marcos-paltatech/sonar-invidentes/hardware/img/srf02.png

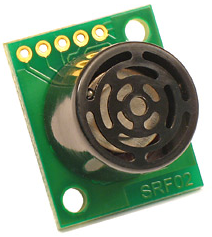
hardware/img/srf02.png
