marcos-paltatech/sonar-invidentes/readme.txt

audio/
    Tracks de audio, instrucciones para grabar tracks, etc.
    Utilizamos Audacity para manipular audio.

datasheets/
    Datasheets de componentes, application notes, etc.

doc/
    Archivos de documentacion varios.

flashmem/
    Programa para flashear la memoria flash del sistema.
    Esta implementado en C++ con Qt y funciona en Linux.

hardware/
    Esquematicos y archivos relacionados a la implementacion del proyecto en una placa.
    El proyecto esta hecho con KiCAD.

hardware_proto/
    Esquematicos y archivos relacionados a la implementacion de prueba del proyecto,
    utilizando una placa STM32-Discovery.
    El proyecto esta hecho con KiCAD.

STMProject/
    Proyecto para el prototipo usando la placa STM32-Discovery.
    El proyecto es para el IDE "Atollic TrueSTUDIO for STMicroelectronics STM32".
	
SonarBoardProject/
	Proyecto para la placa SonarBoard.
	El proyecto es para el IDE "CooCox".
