marcos-paltatech/sonar-invidentes/hardware/doc/sonarboard_1.png

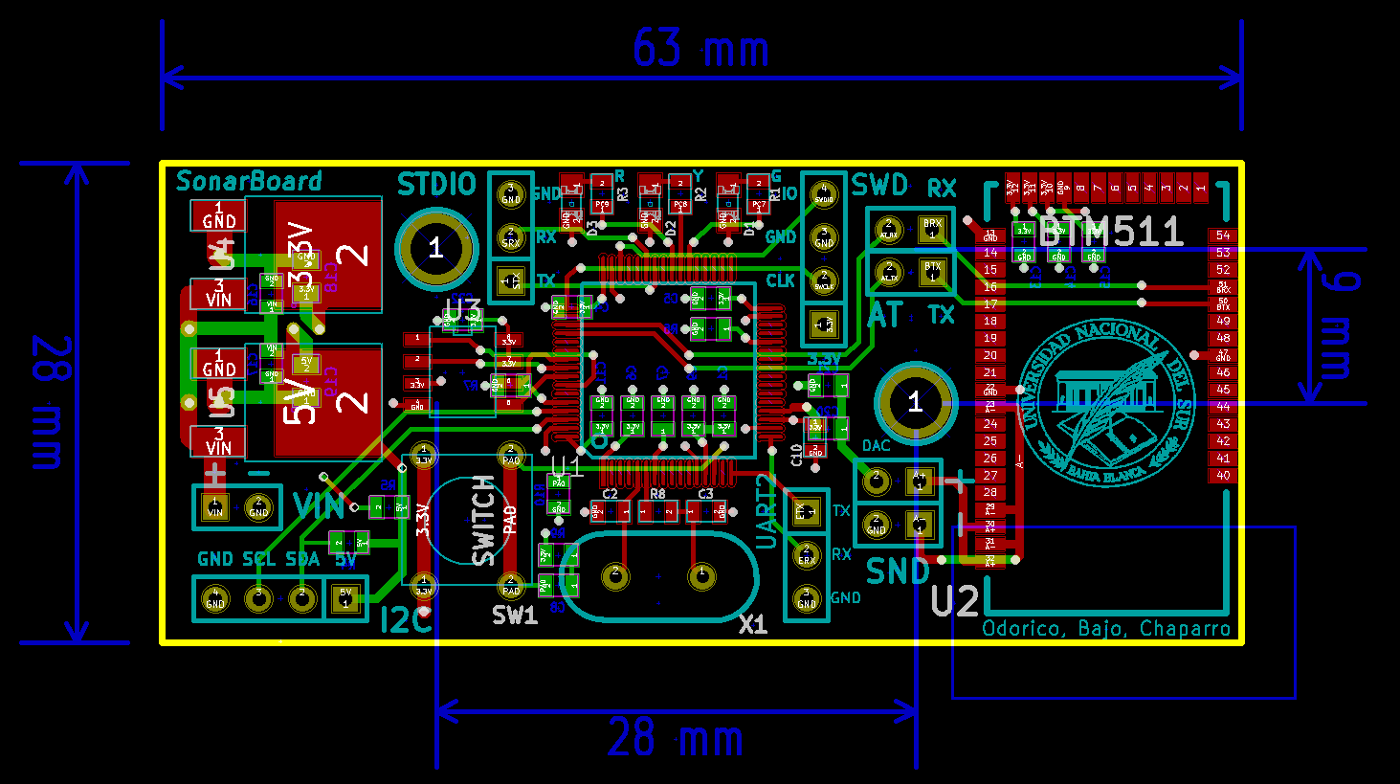
hardware/doc/sonarboard_1.png
