marcos-paltatech/sonar-invidentes/hardware/doc/sonarboard_1_3d.png

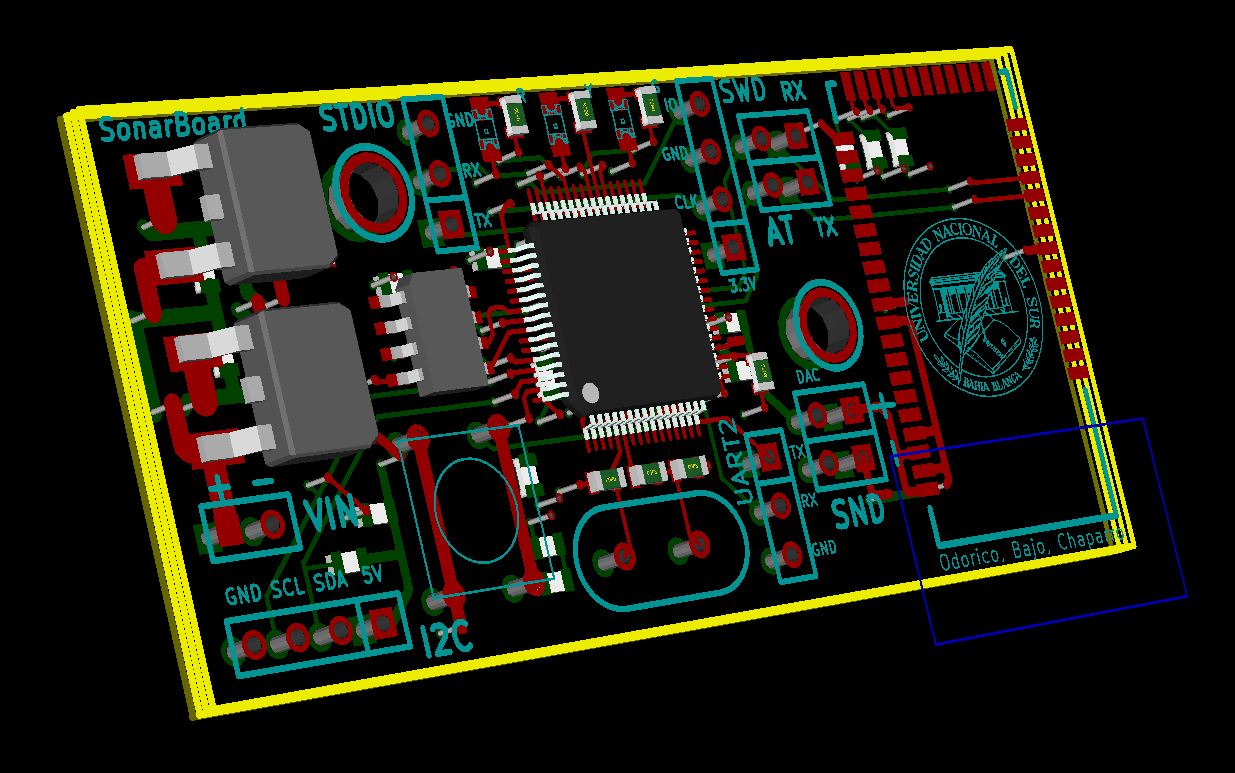
hardware/doc/sonarboard_1_3d.png
