marcos-paltatech/sonar-invidentes/hardware/doc/sonarboard_2.png

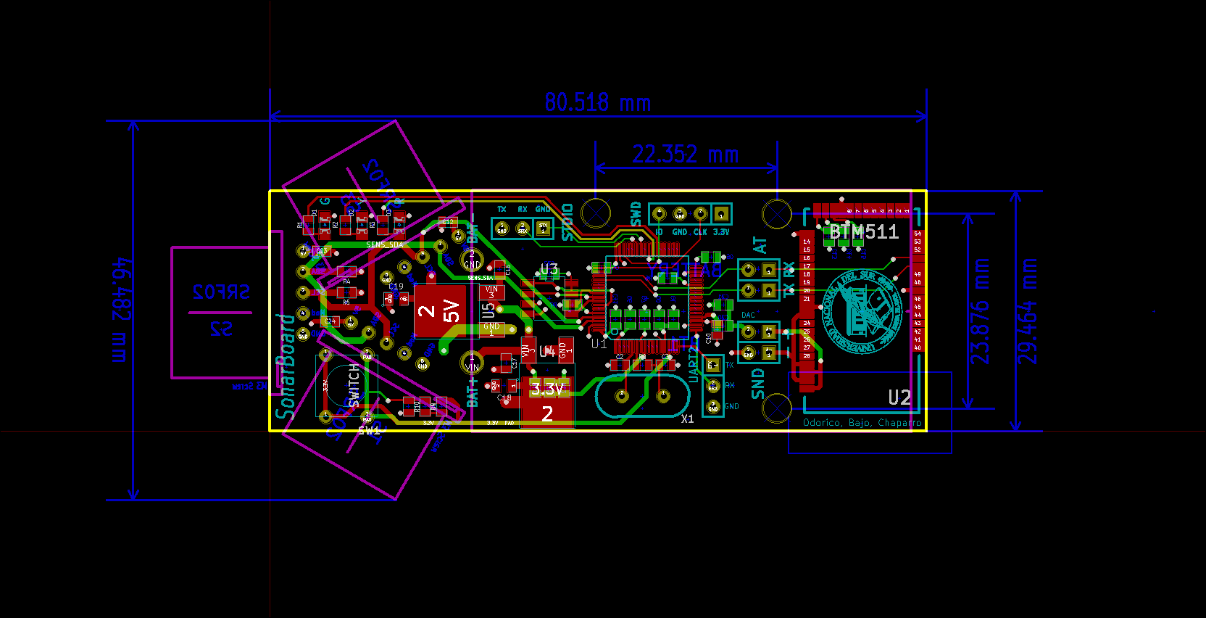
hardware/doc/sonarboard_2.png
