marcos-paltatech/sonar-invidentes/hardware/img/bluetooth.png

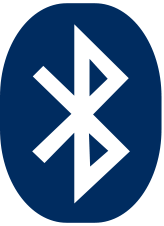
hardware/img/bluetooth.png
