marcos-paltatech/sonar-invidentes/hardware/img/ld1117.png

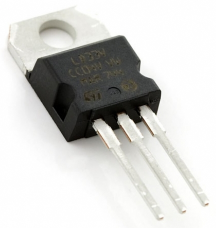
hardware/img/ld1117.png
