marcos-paltatech/sonar-invidentes/hardware/img/stm32.png

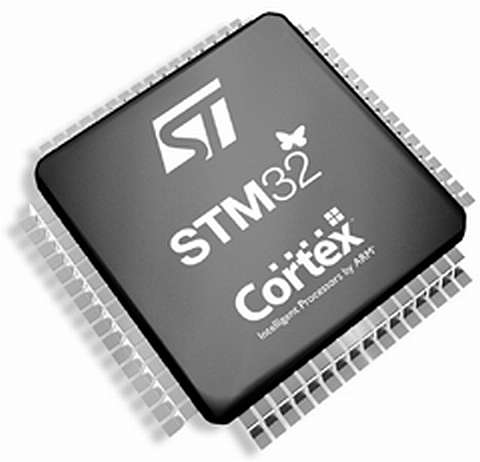
hardware/img/stm32.png
