marcos-paltatech/sonar-invidentes/hardware/img/uns.png

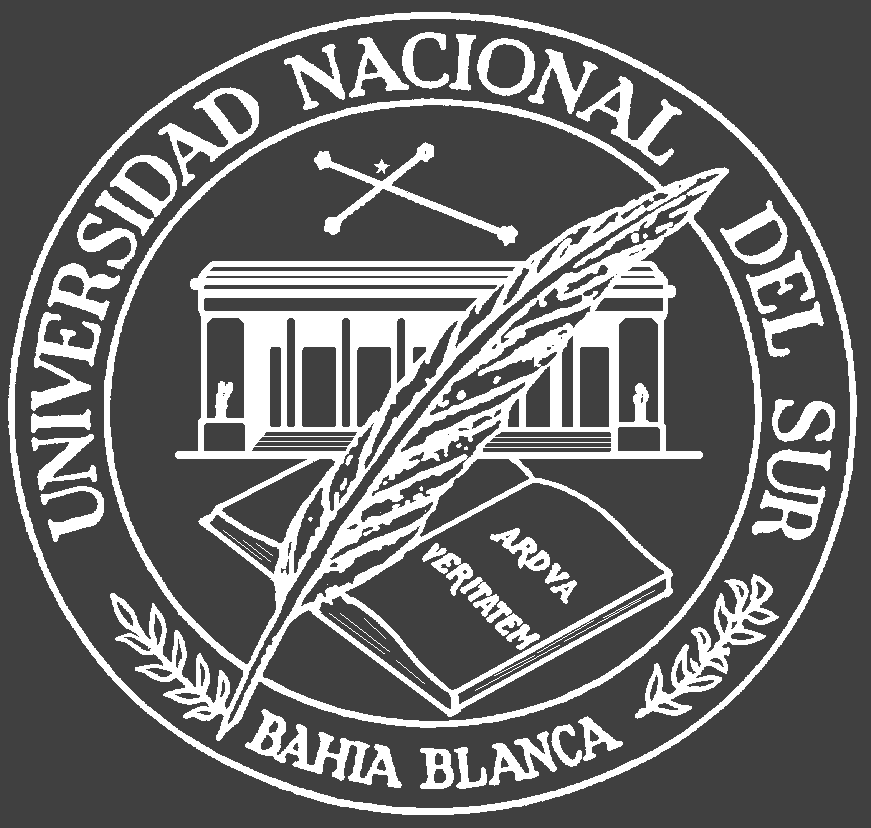
hardware/img/uns.png
