marcos-paltatech/sonar-invidentes/hardware_proto/sonar.pdf

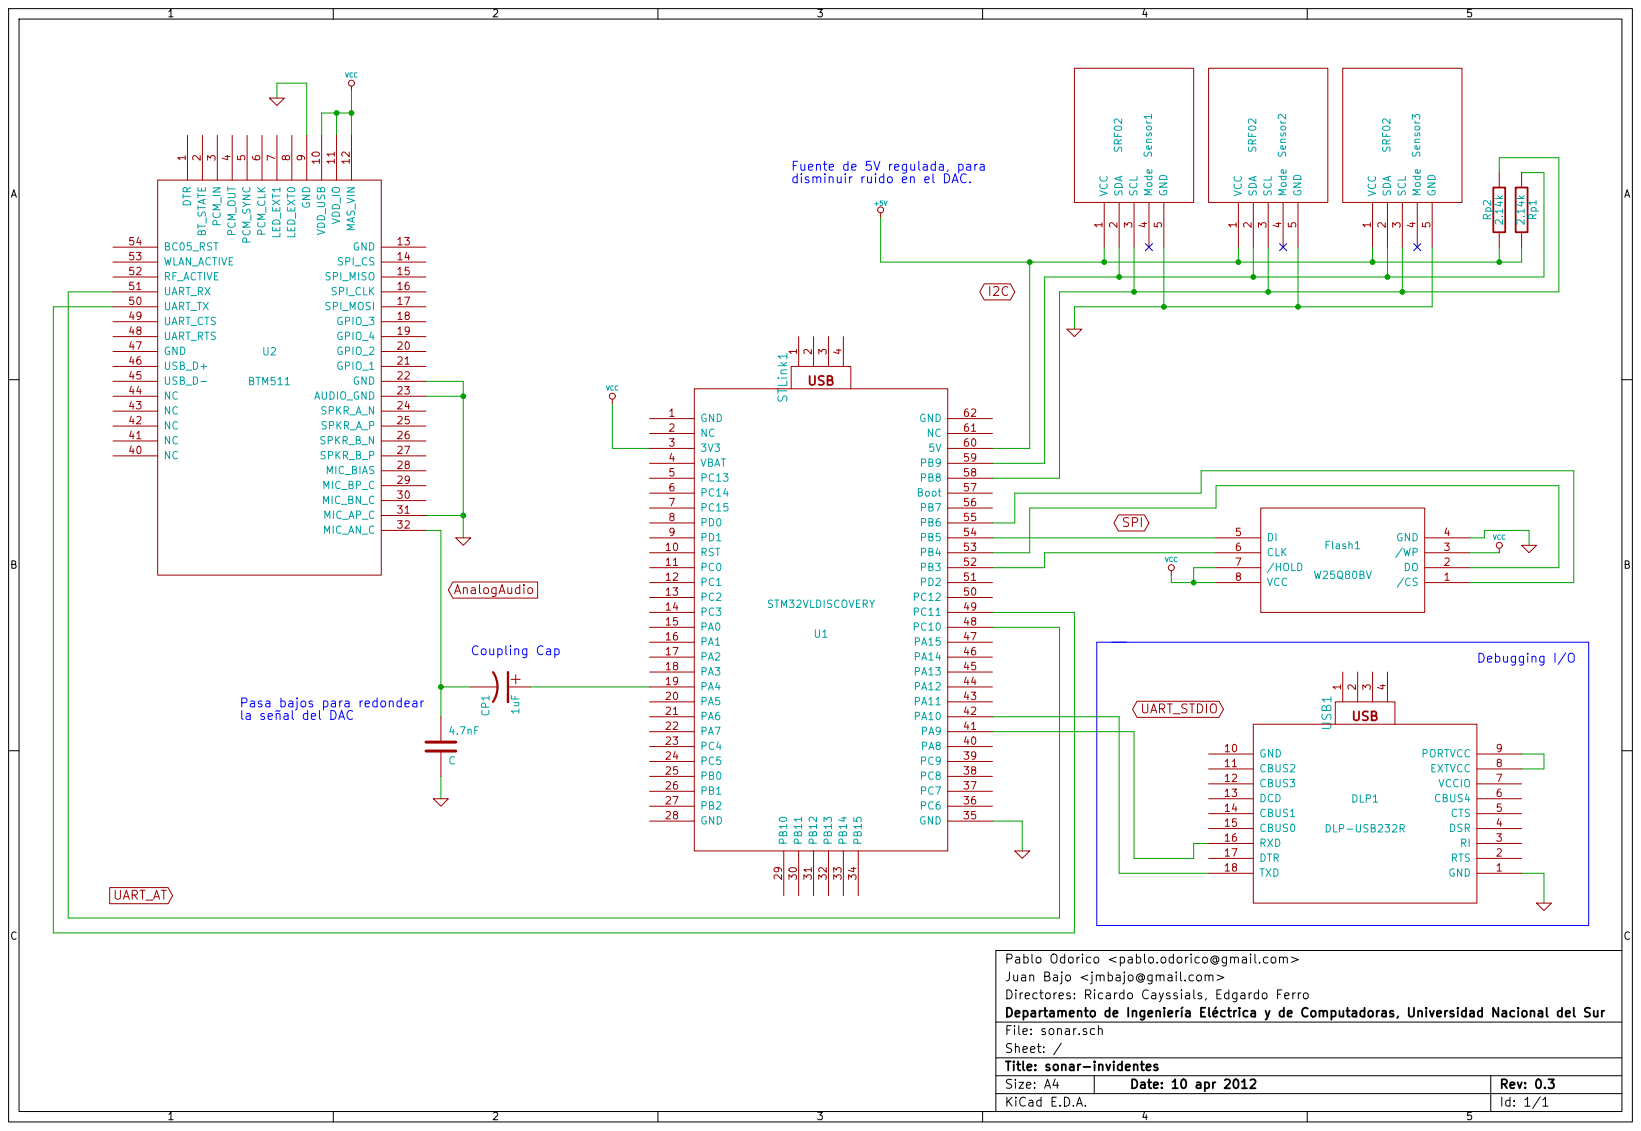
[picture p9: page 1]
