marcos-paltatech/sonar-invidentes/hardware/doc/sonar_board_v04.pdf

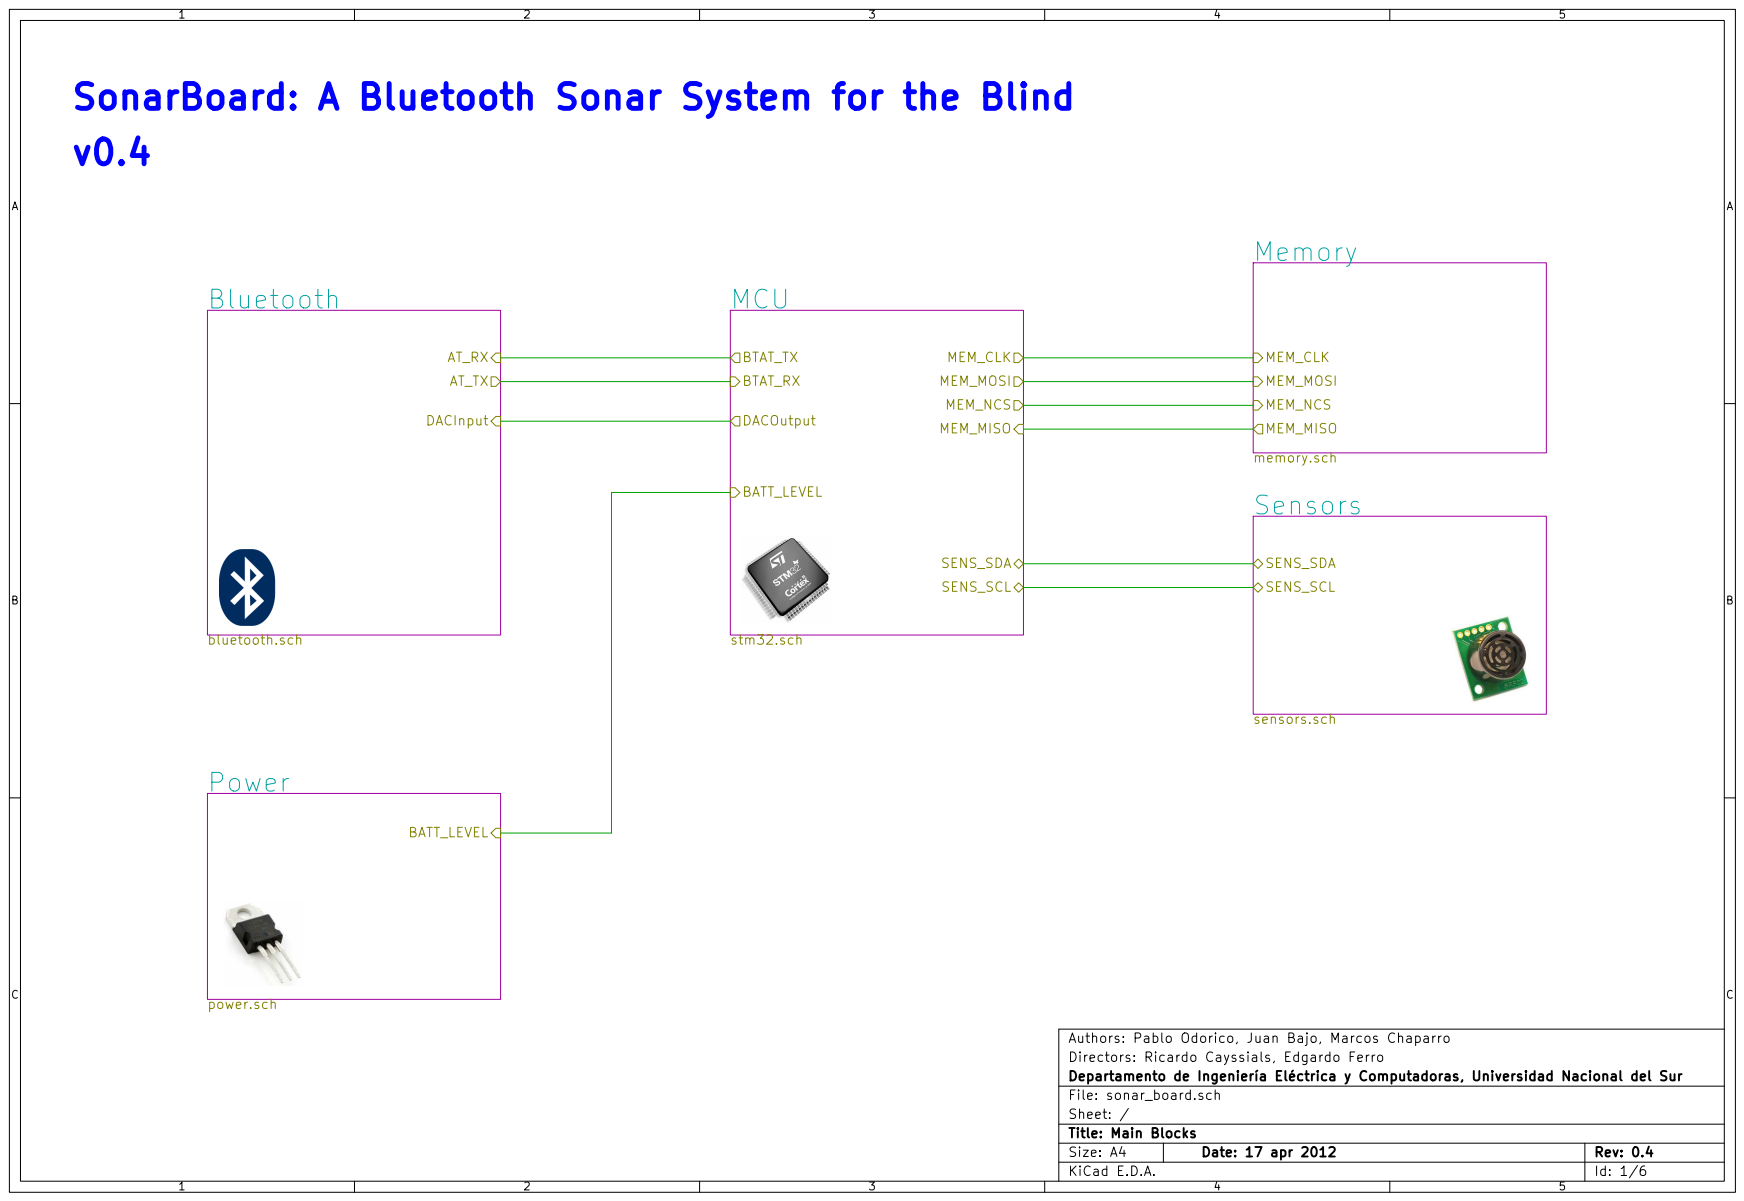
[picture p10: page 1]

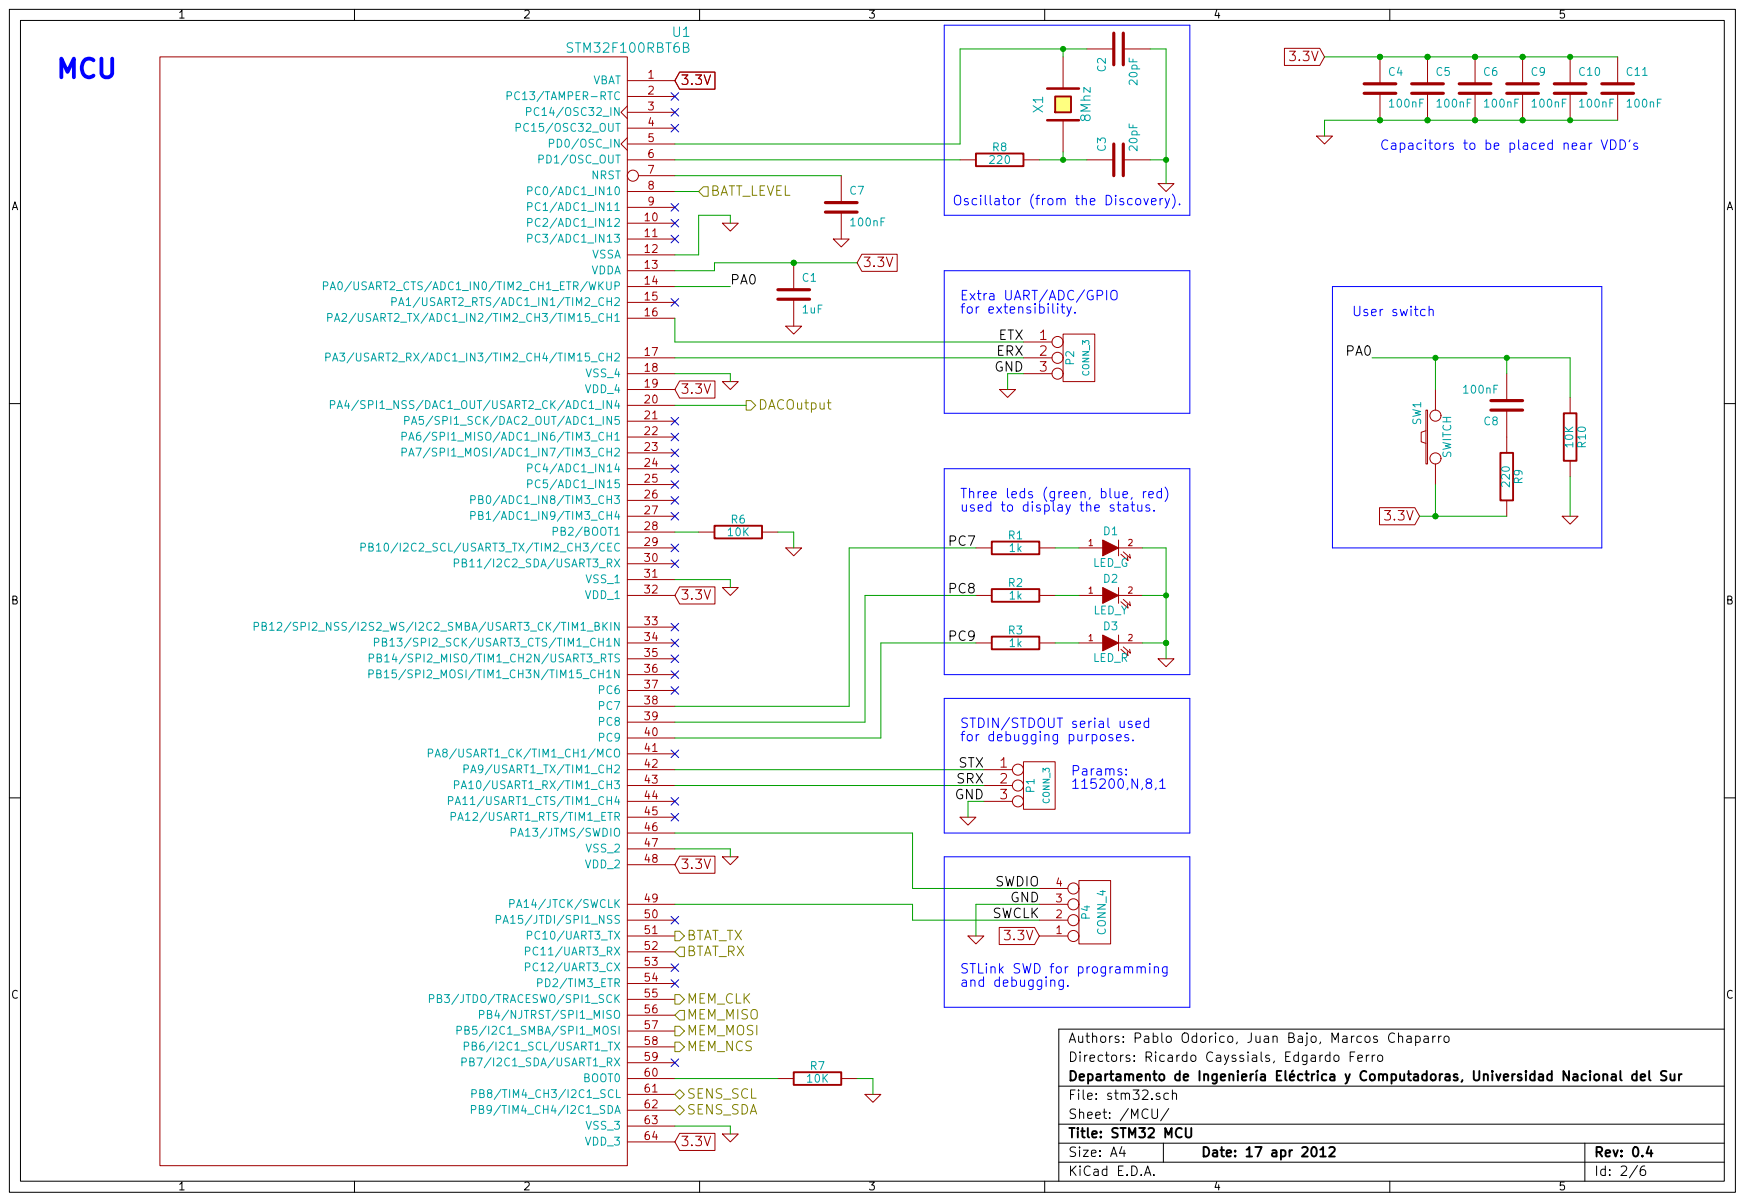
[picture p11: page 2]

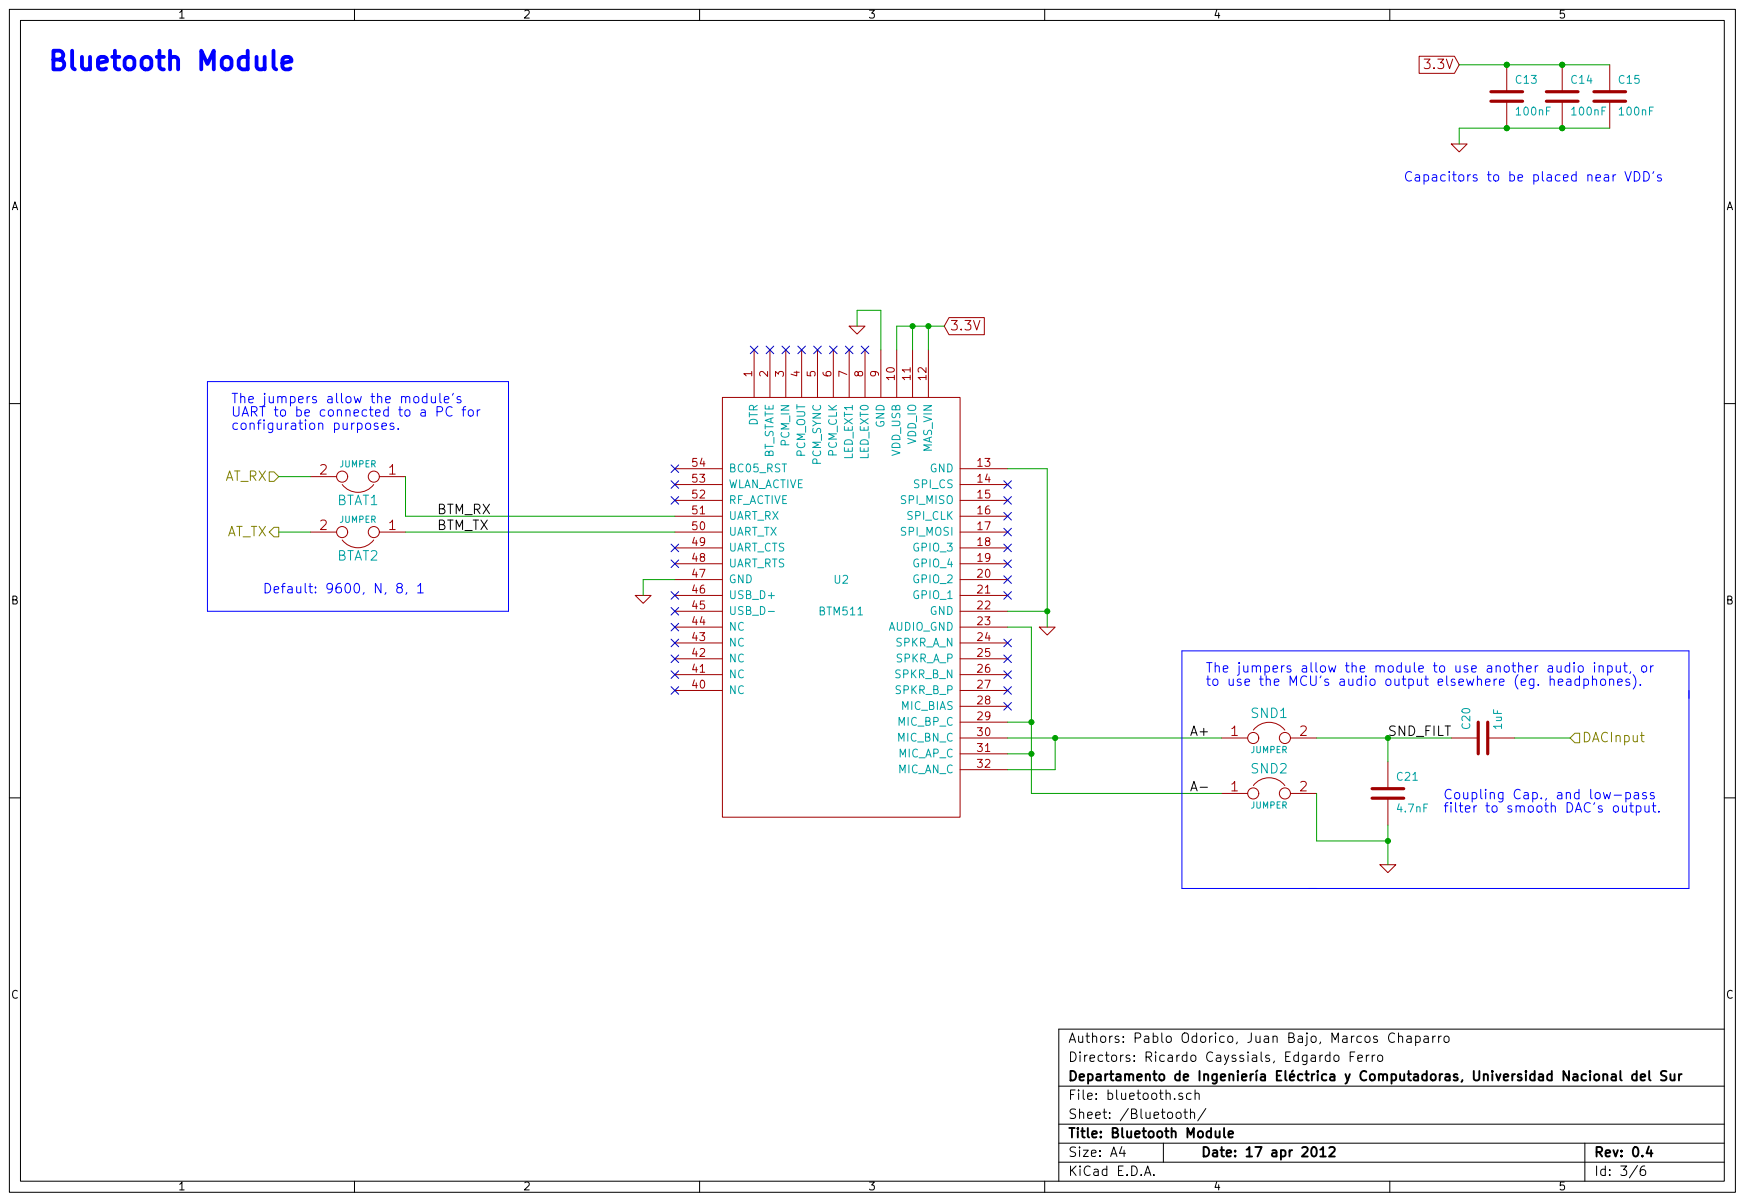
[picture p12: page 3]

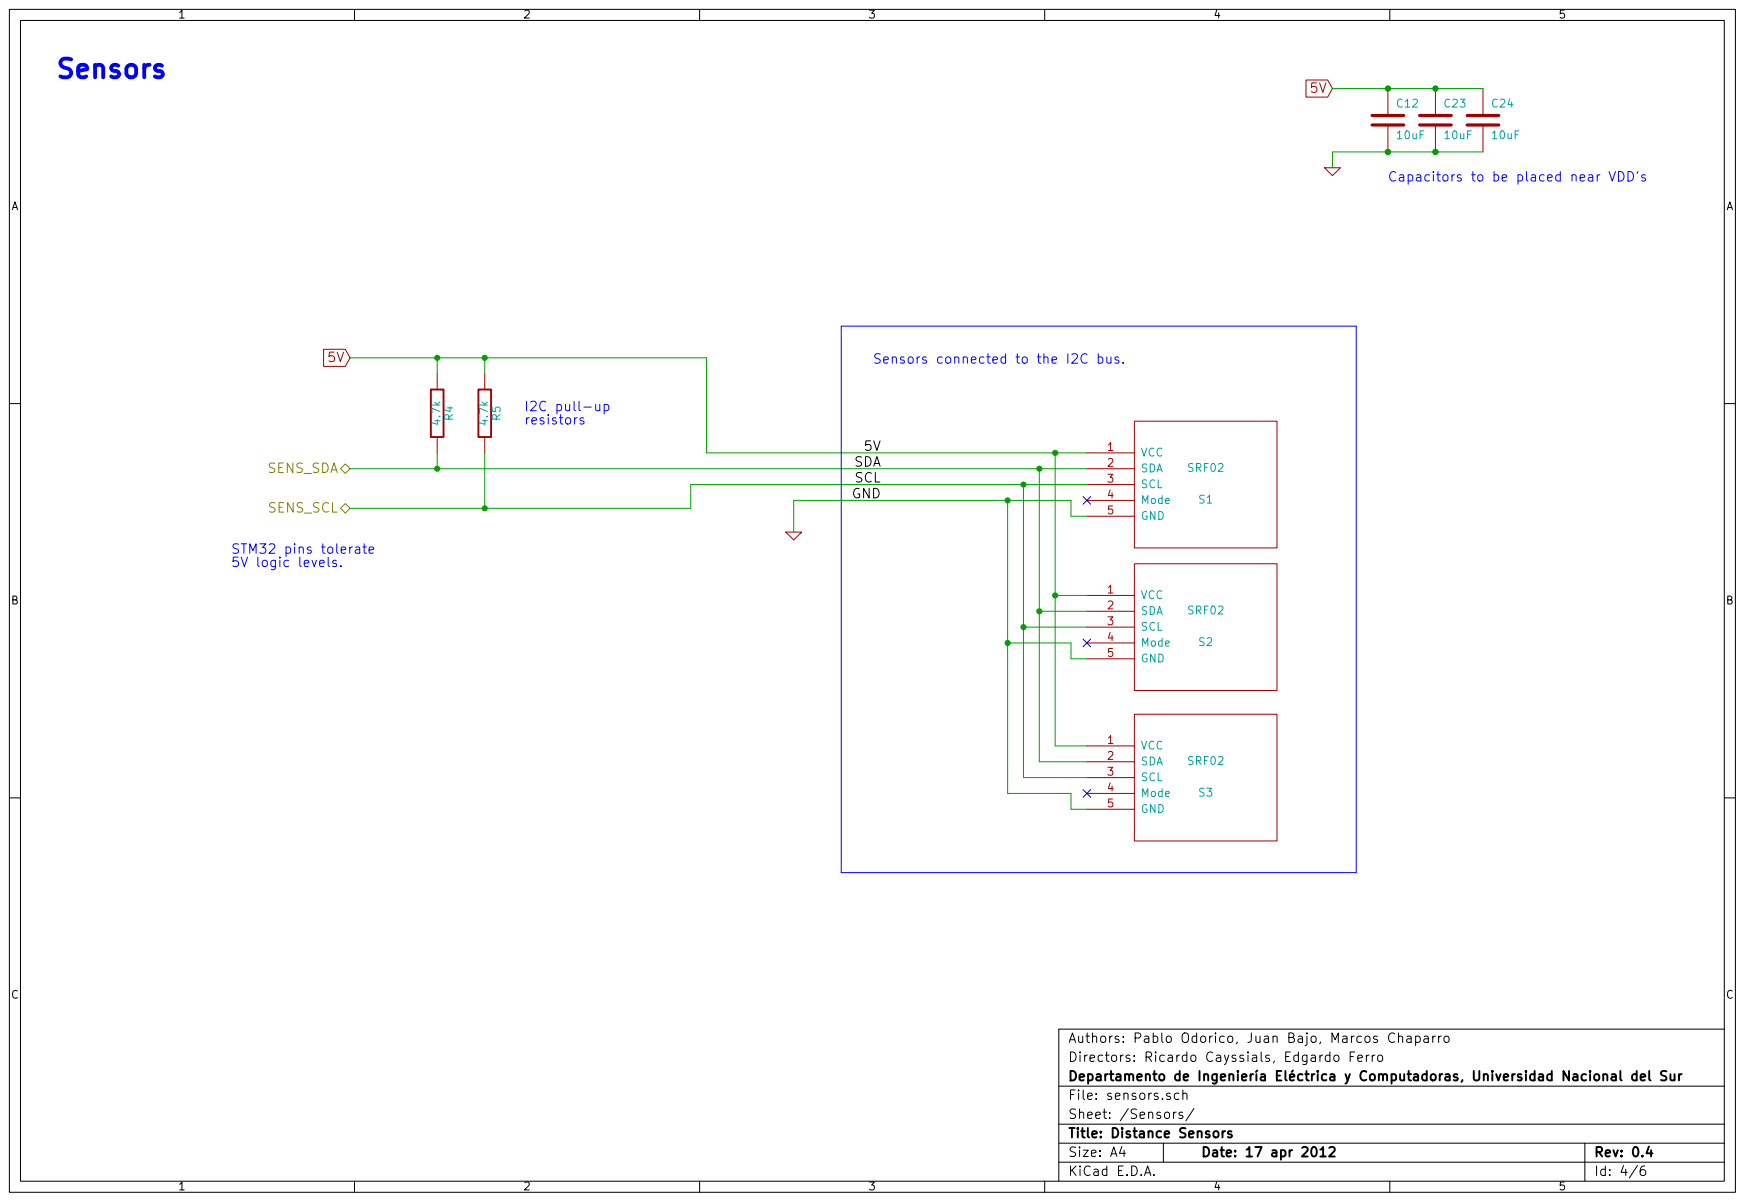
[picture p13: page 4]

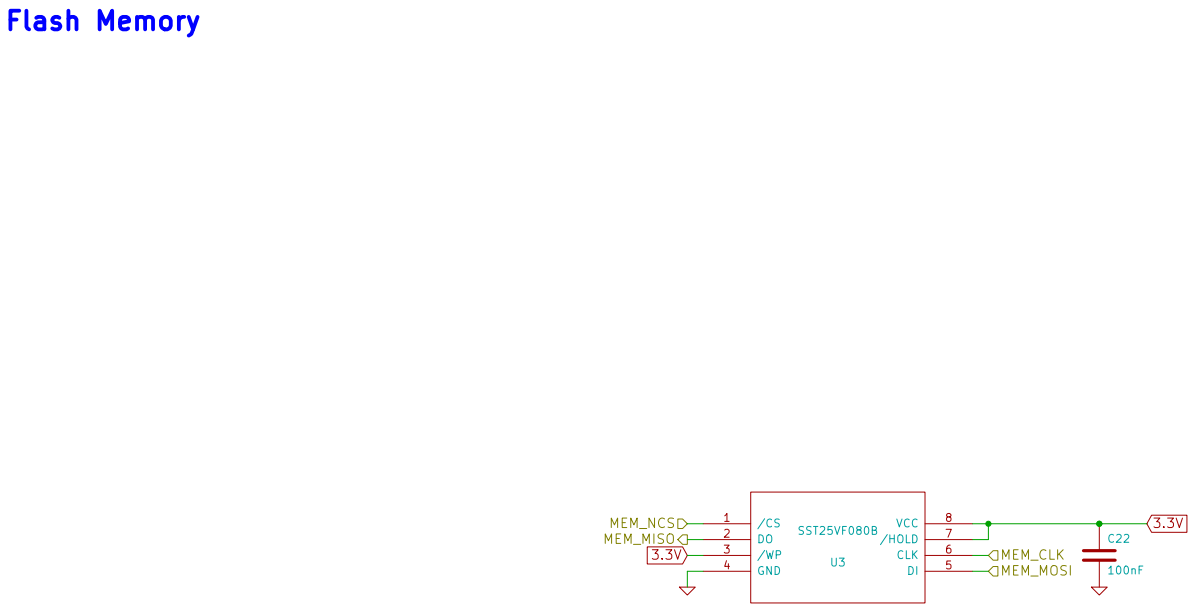
[picture p14: page 5]

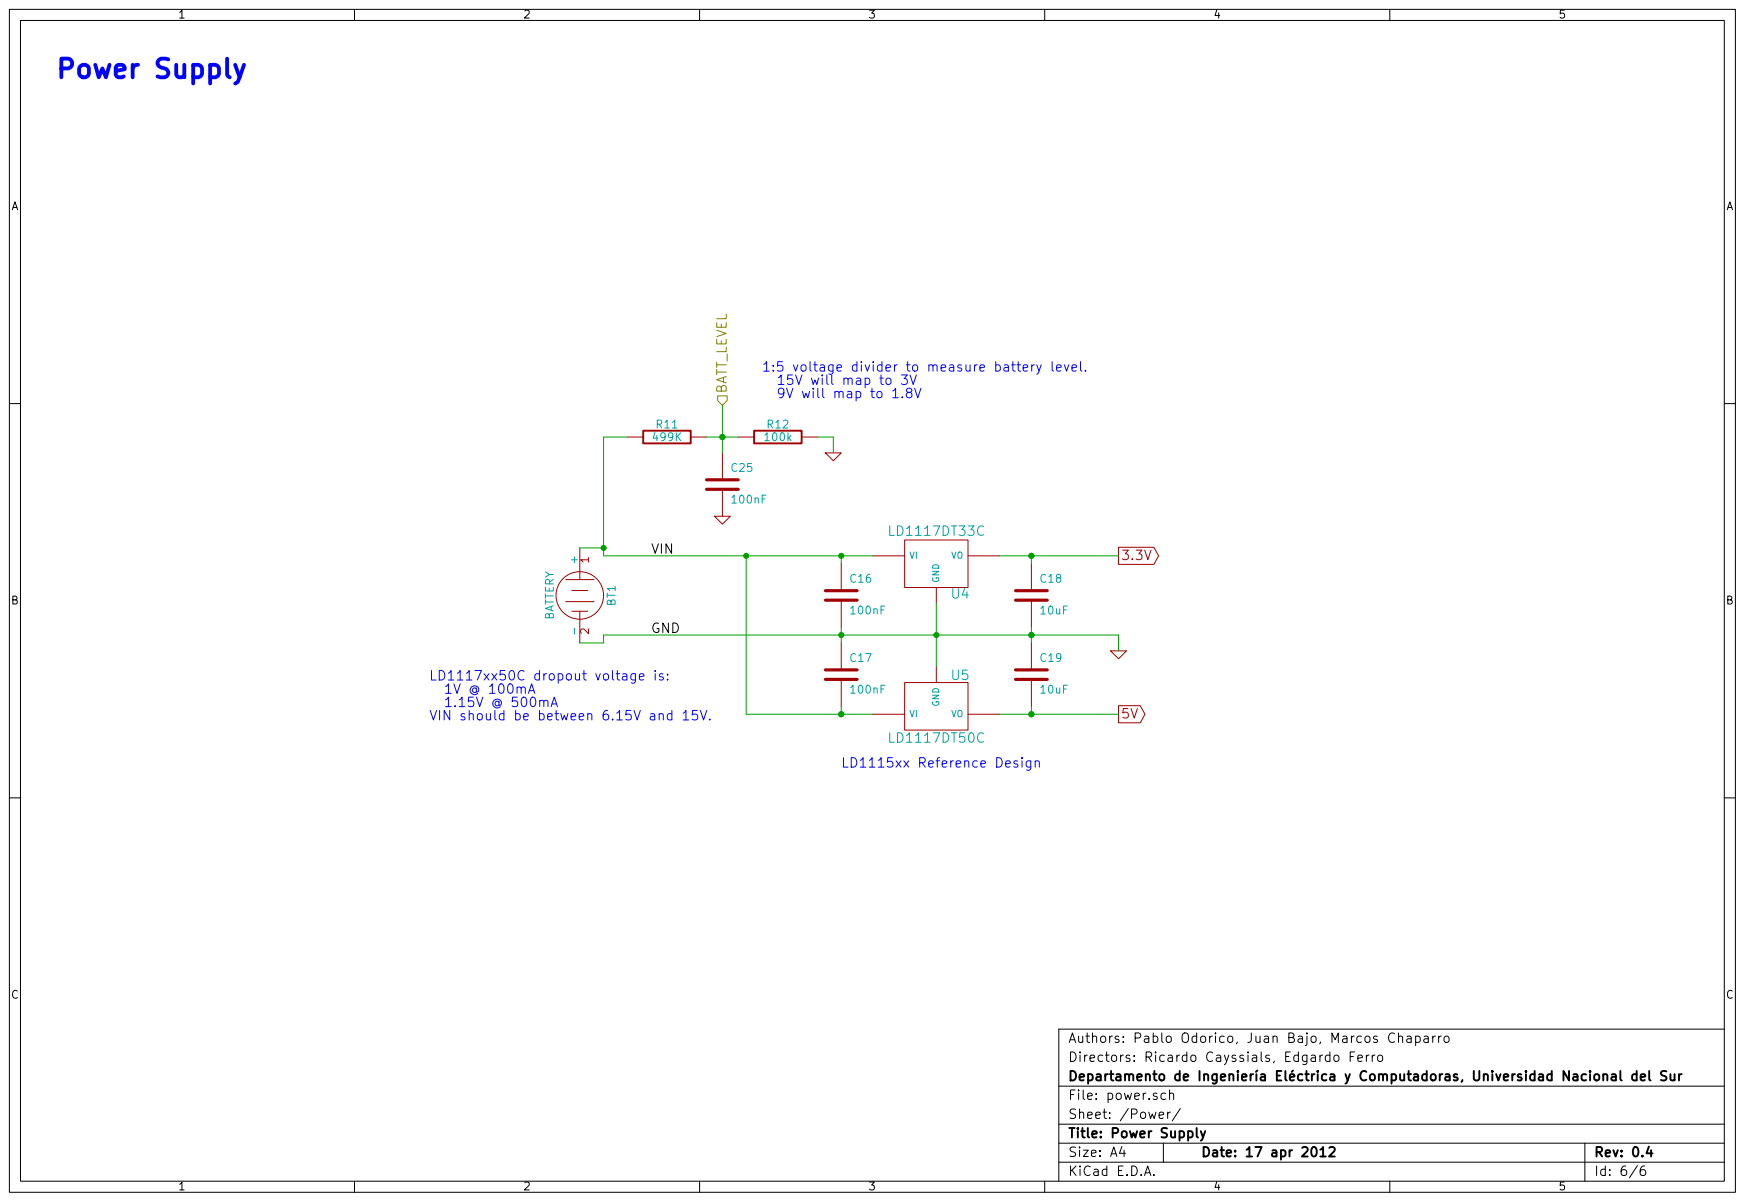
[picture p15: page 6]

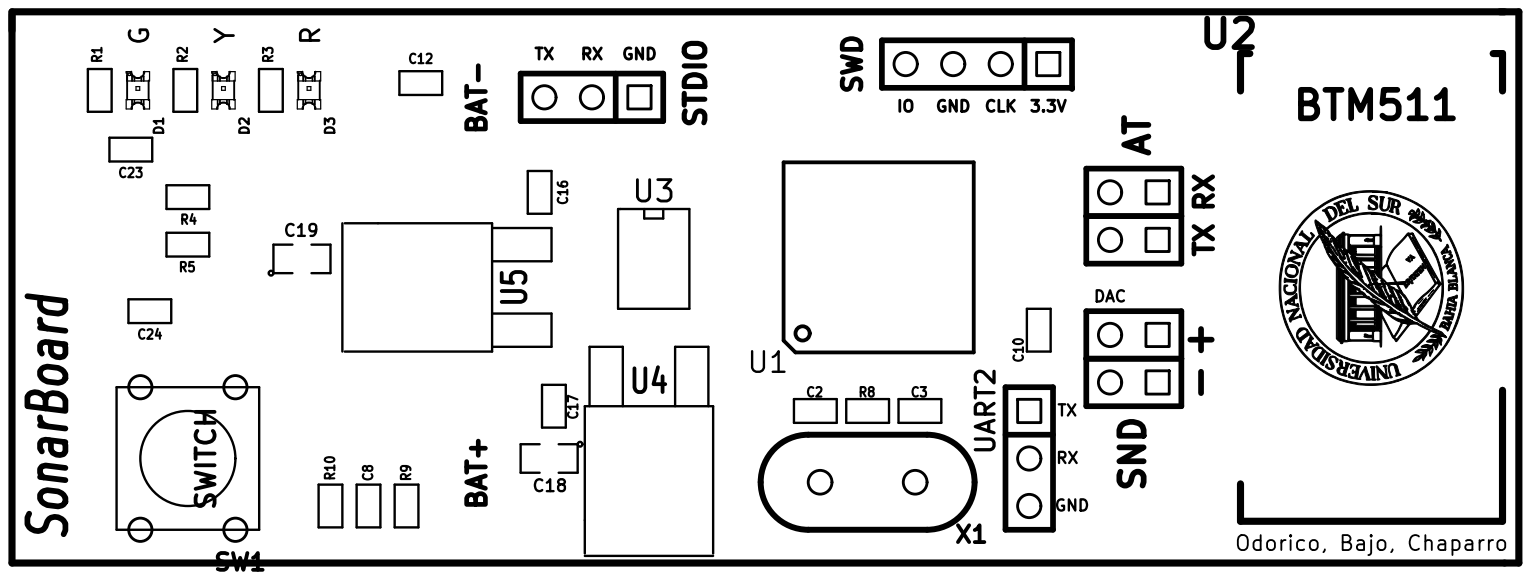
[picture p16: page 7]

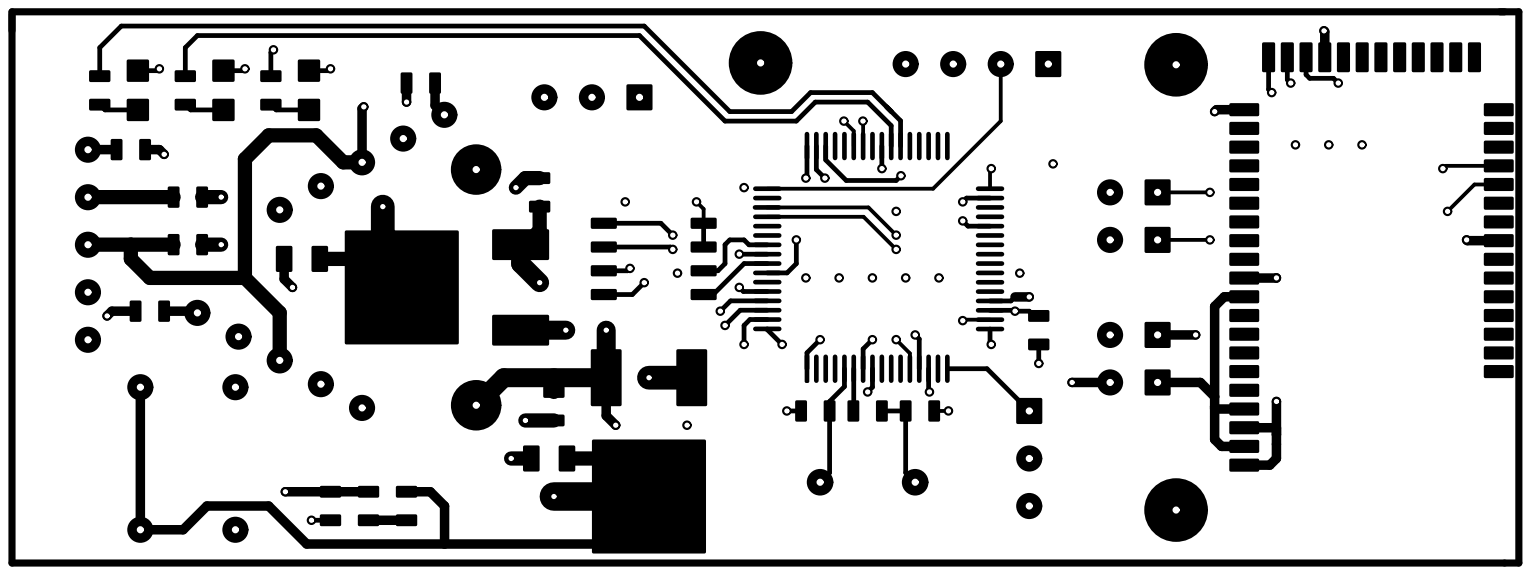
[picture p17: page 8]

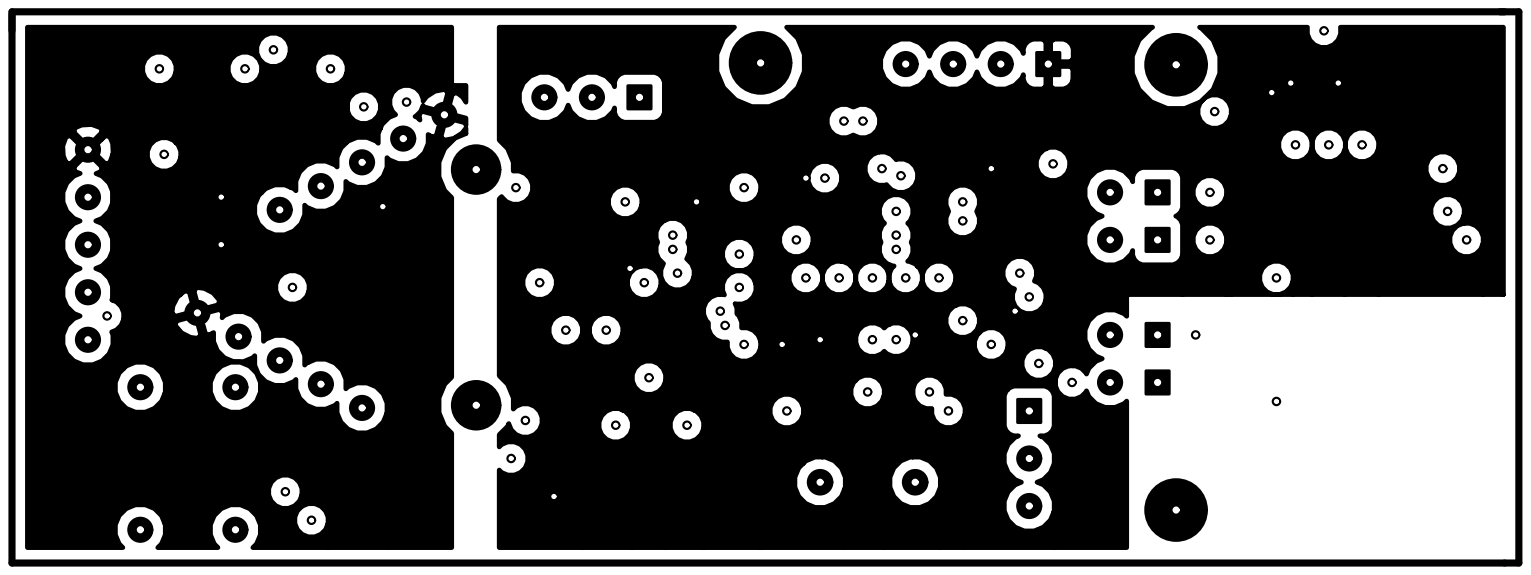
[picture p18: page 9]

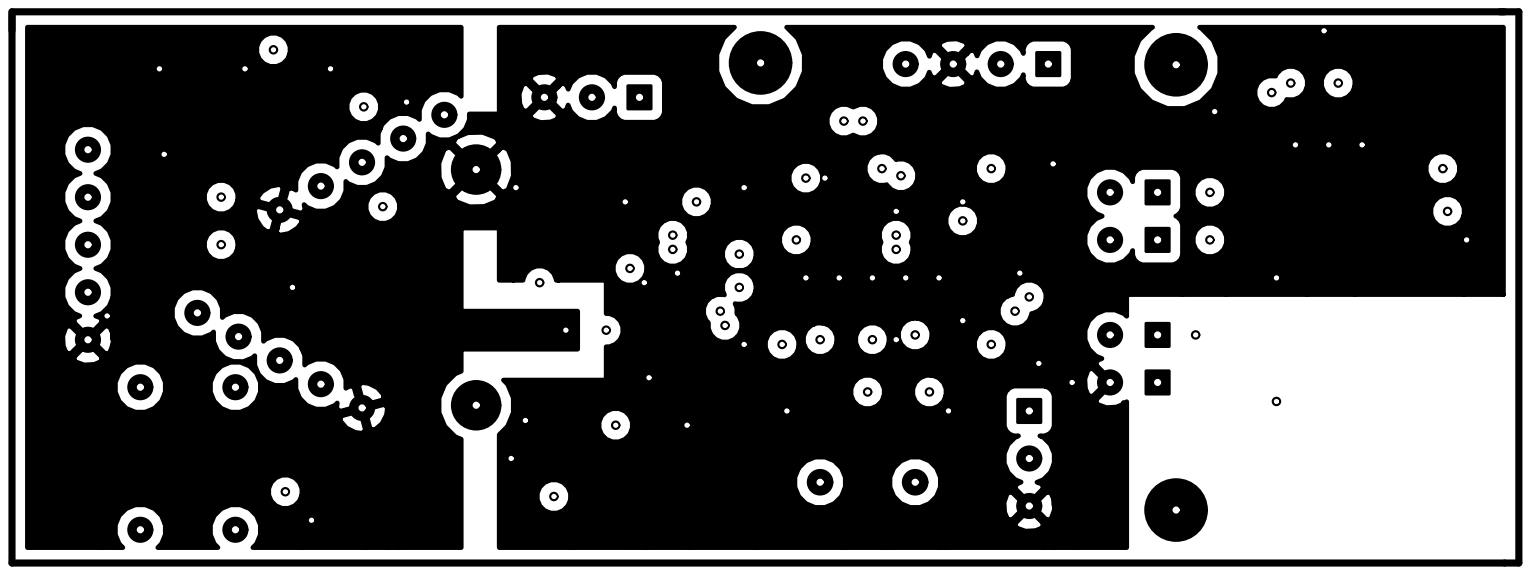
[picture p19: page 10]

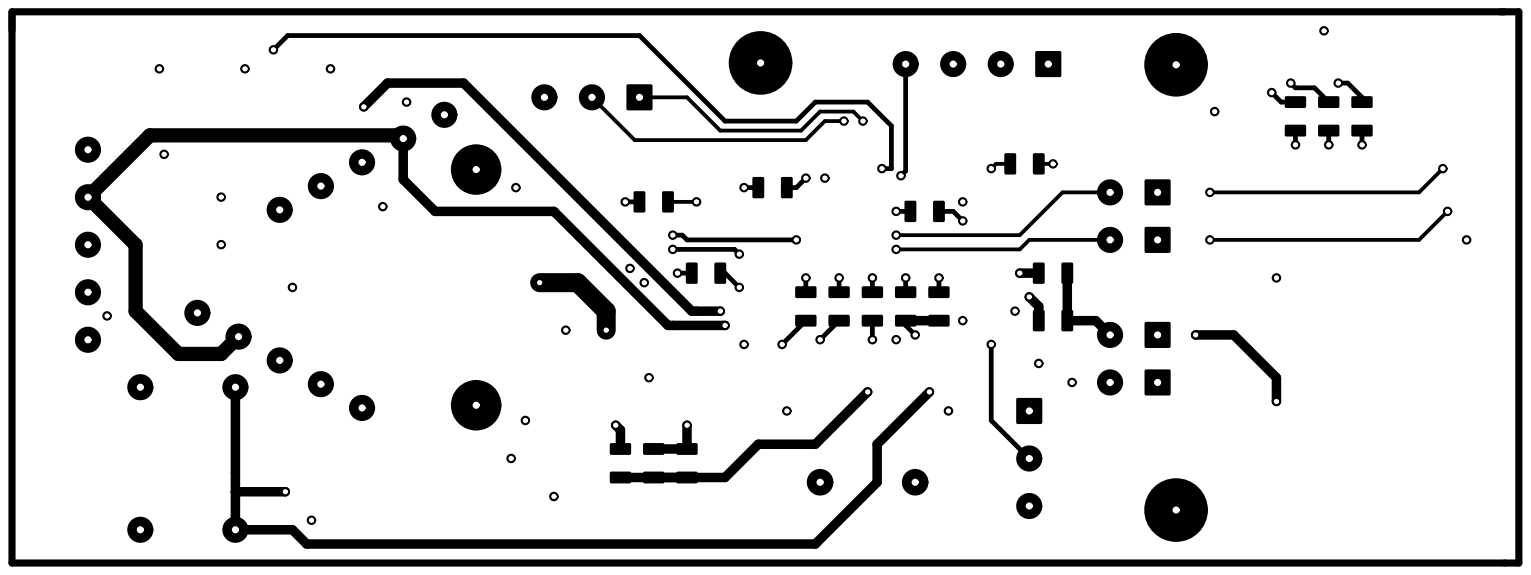
[picture p20: page 11]

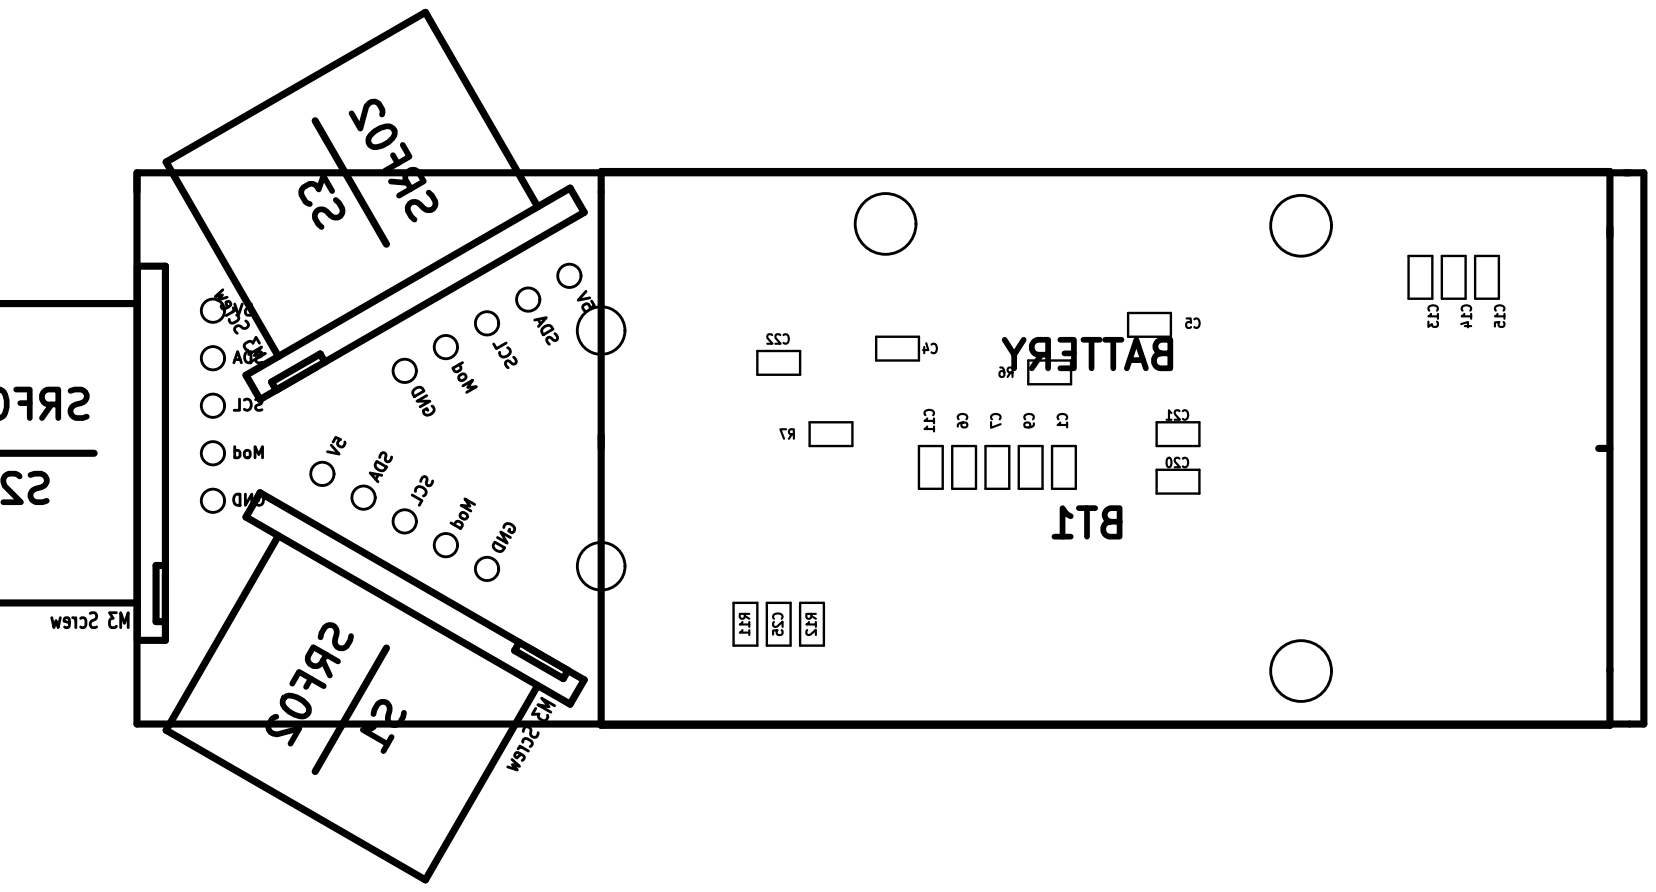
[picture p21: page 12]
