marcos-paltatech/sonar-invidentes/hardware/doc/sonar_board_v03.pdf

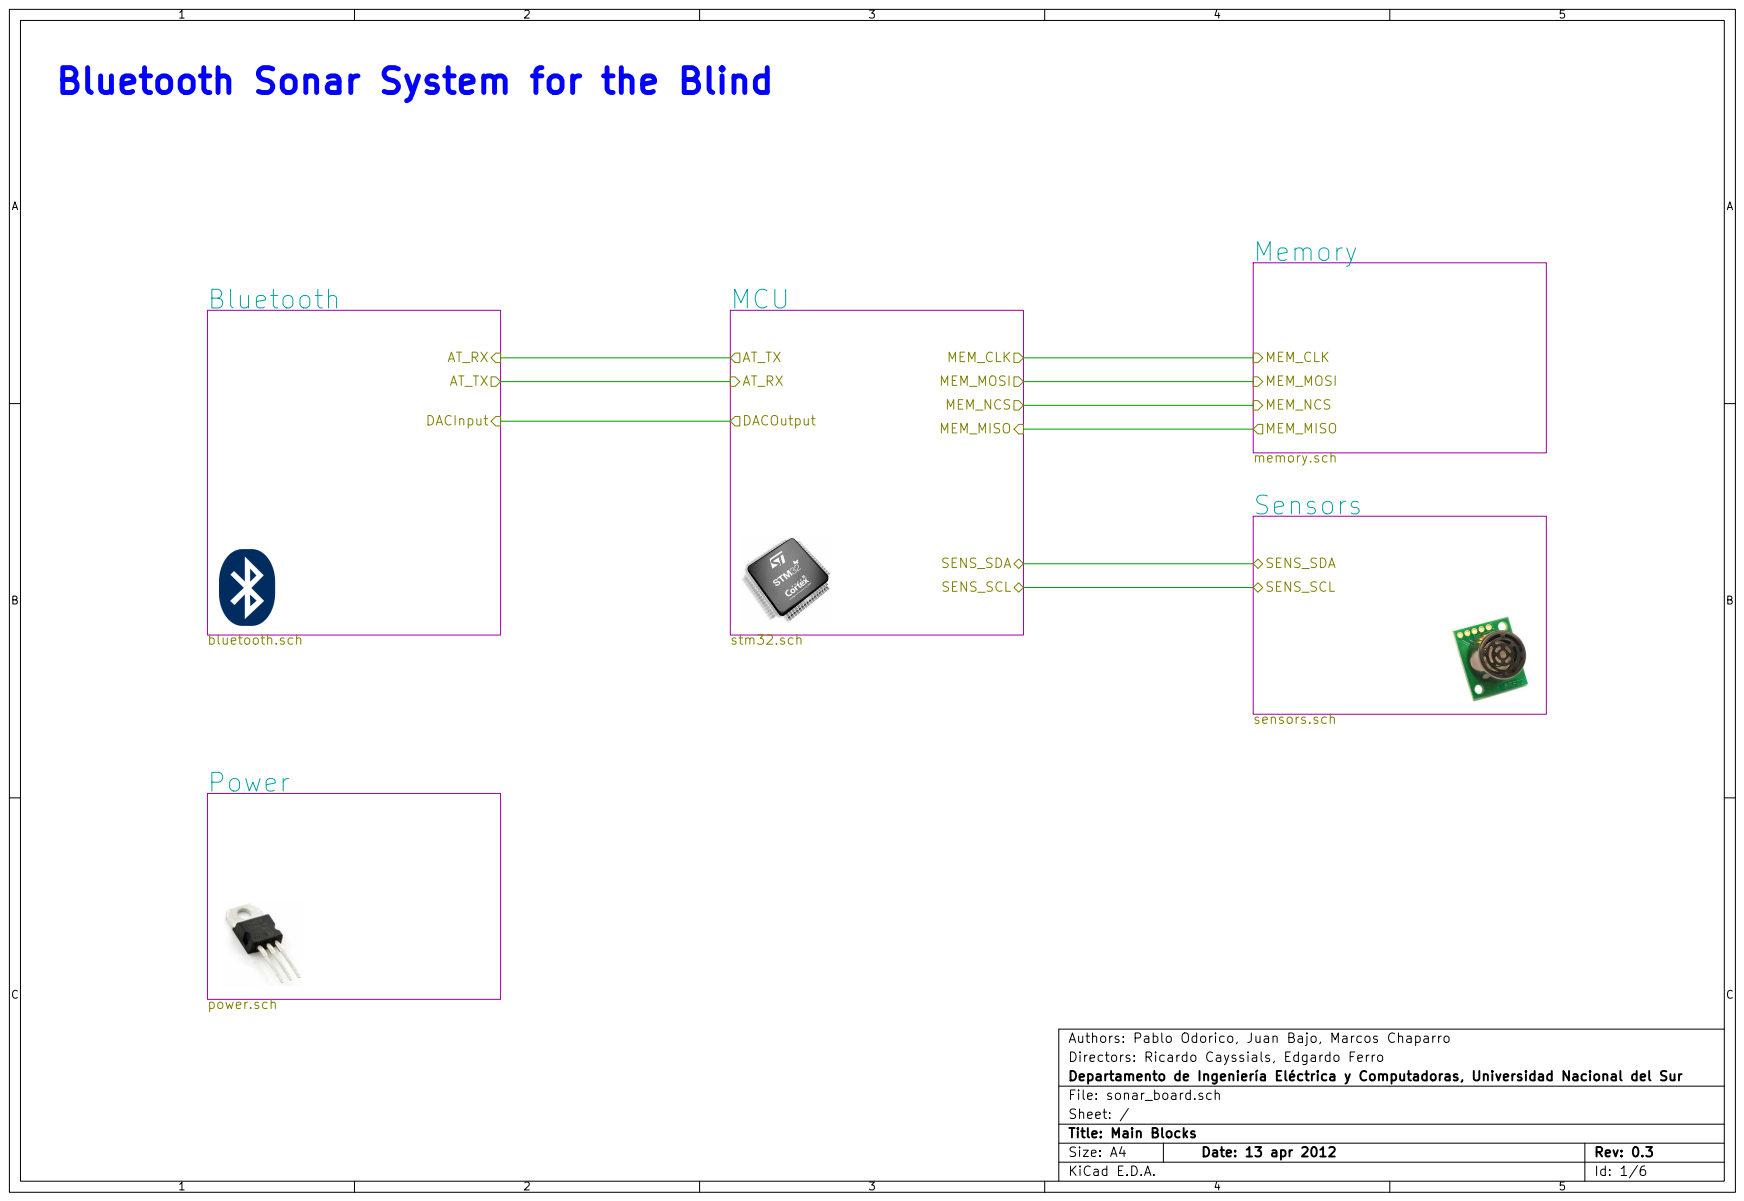
[picture p22: page 1]

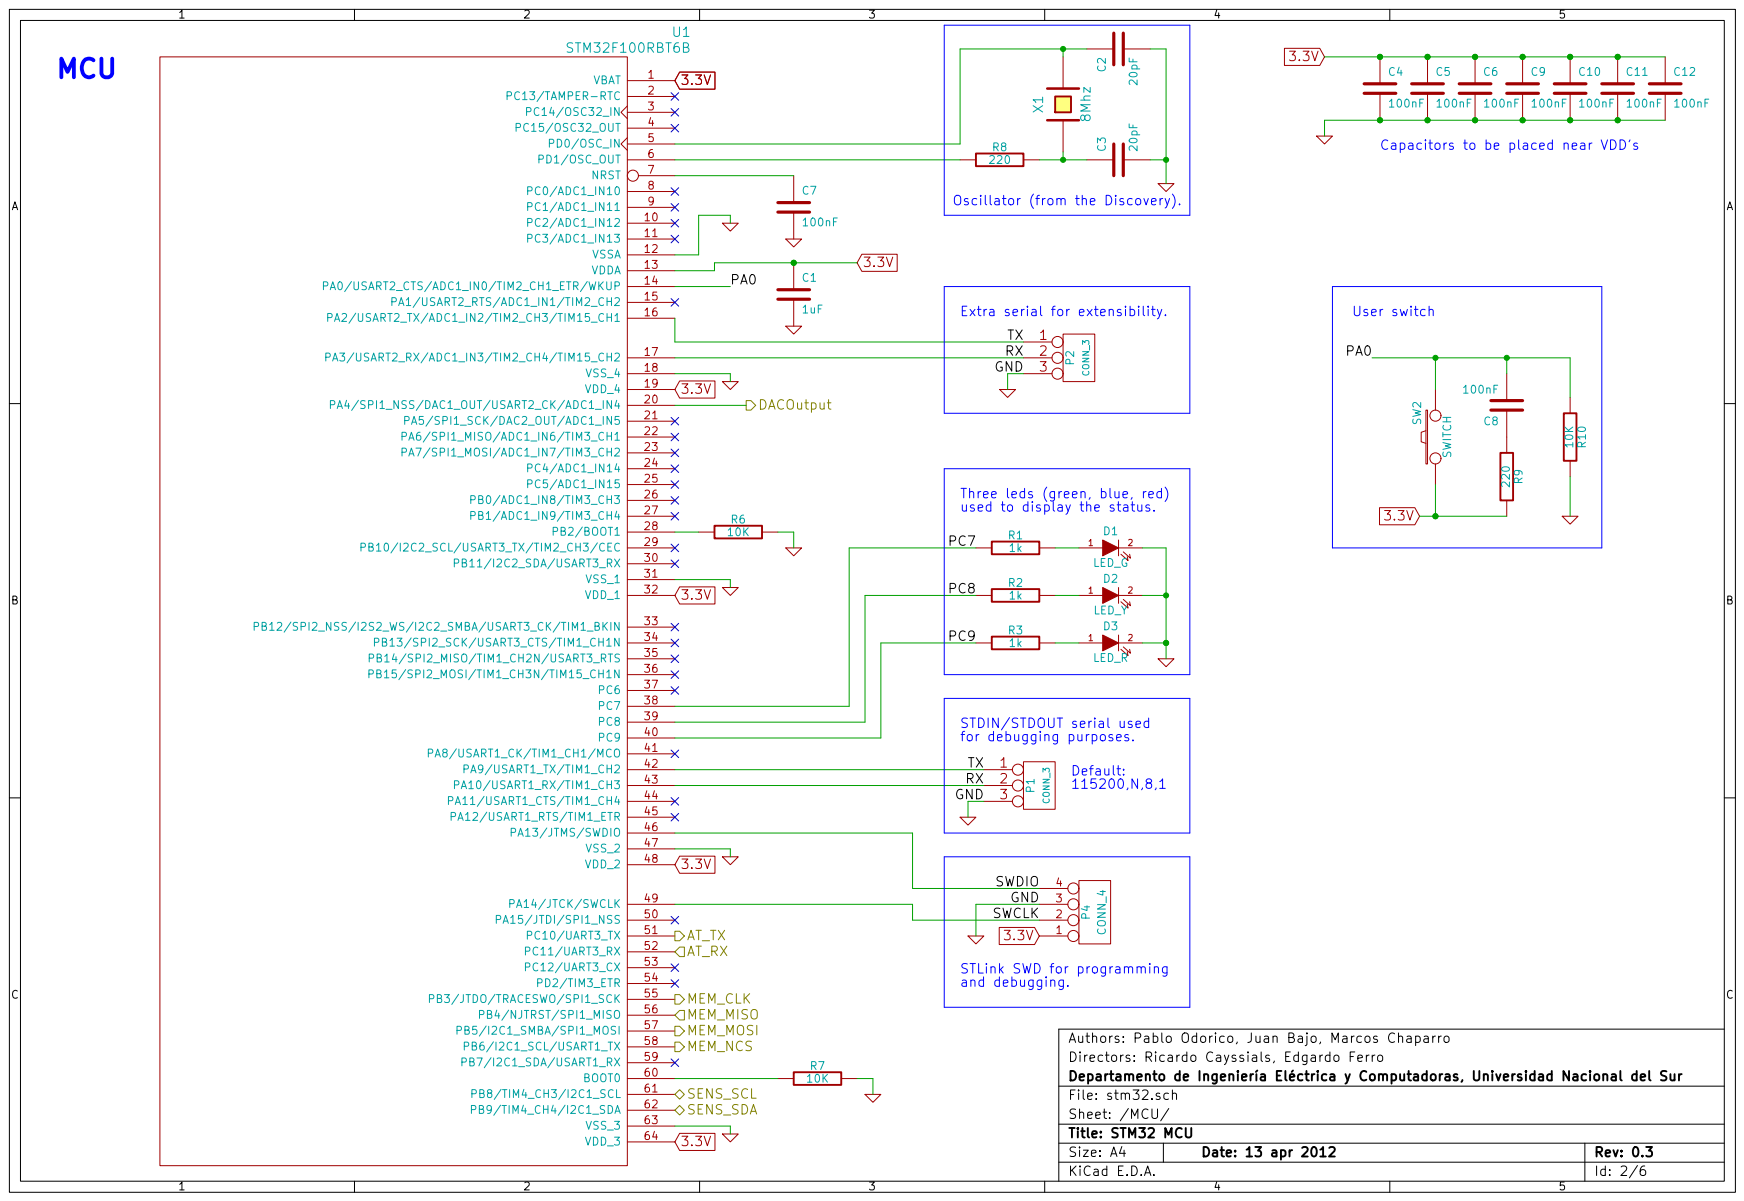
[picture p23: page 2]

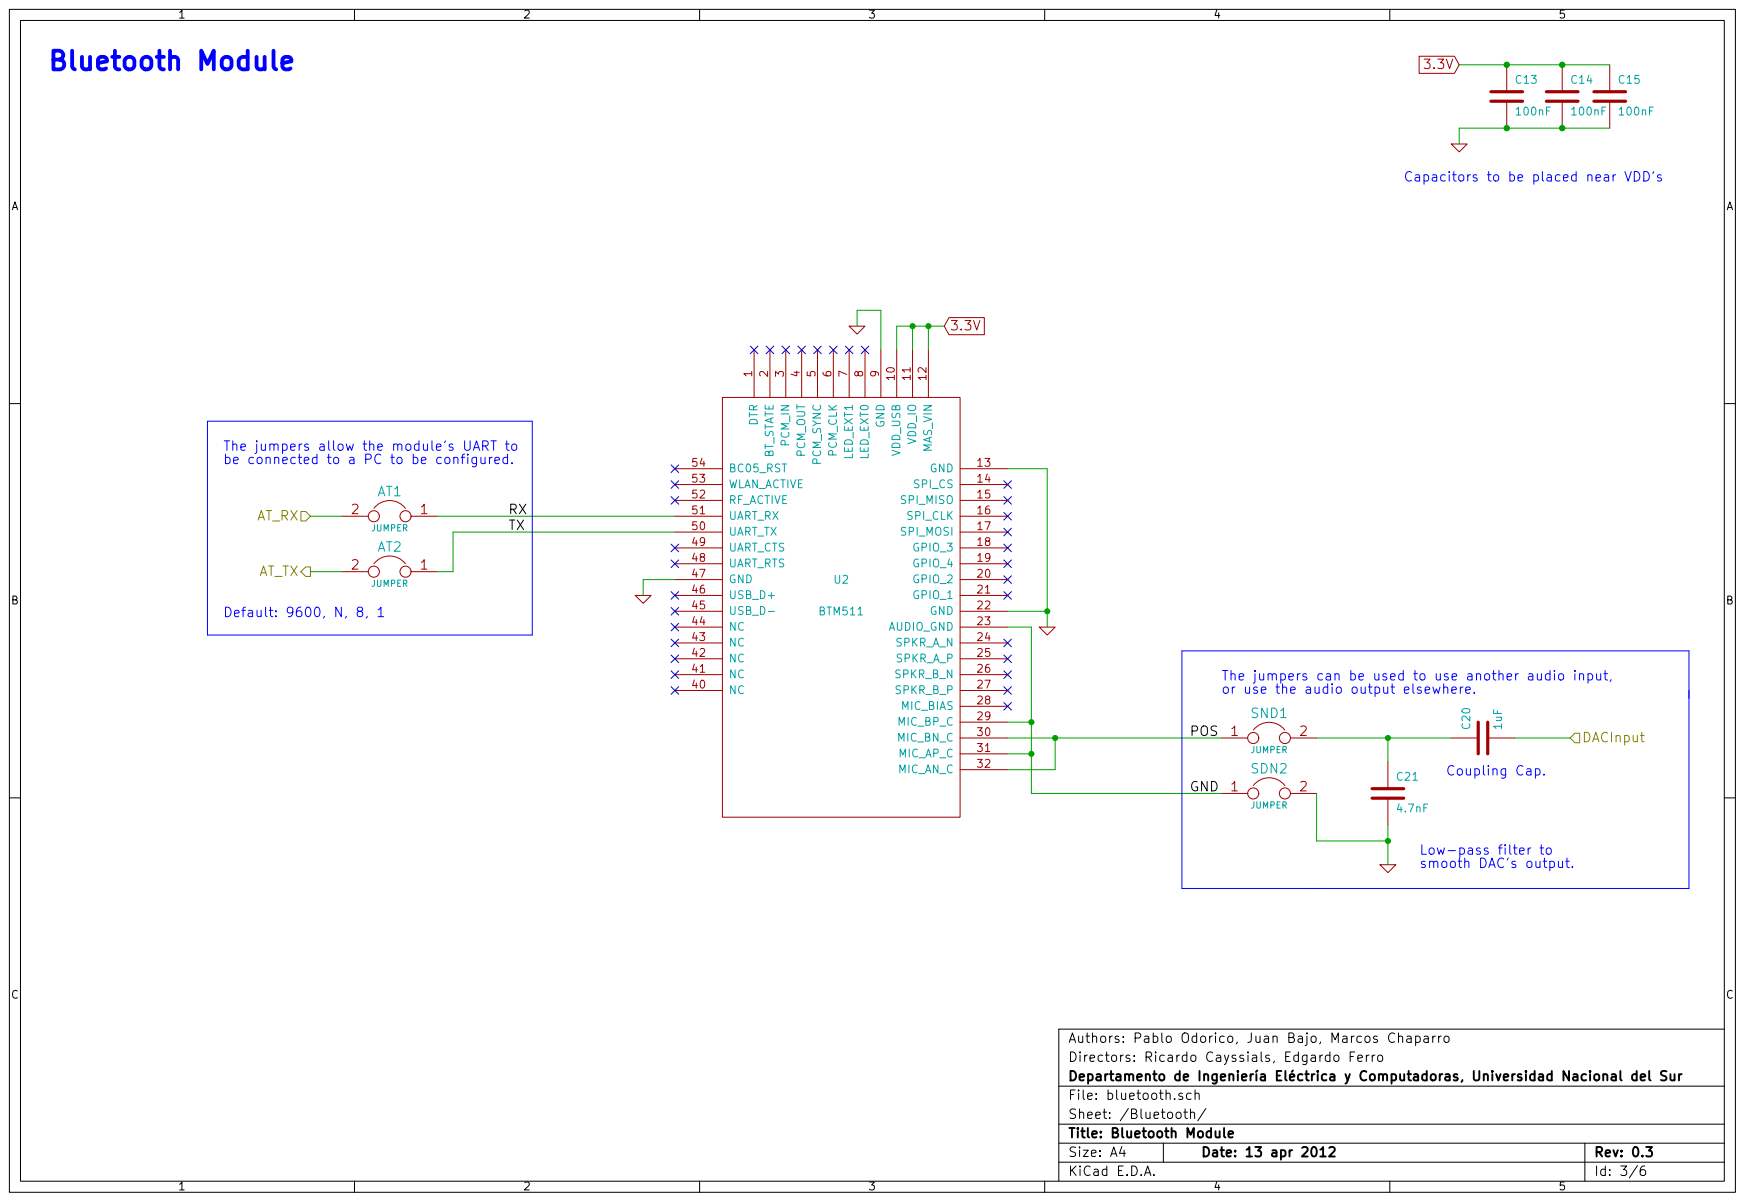
[picture p24: page 3]


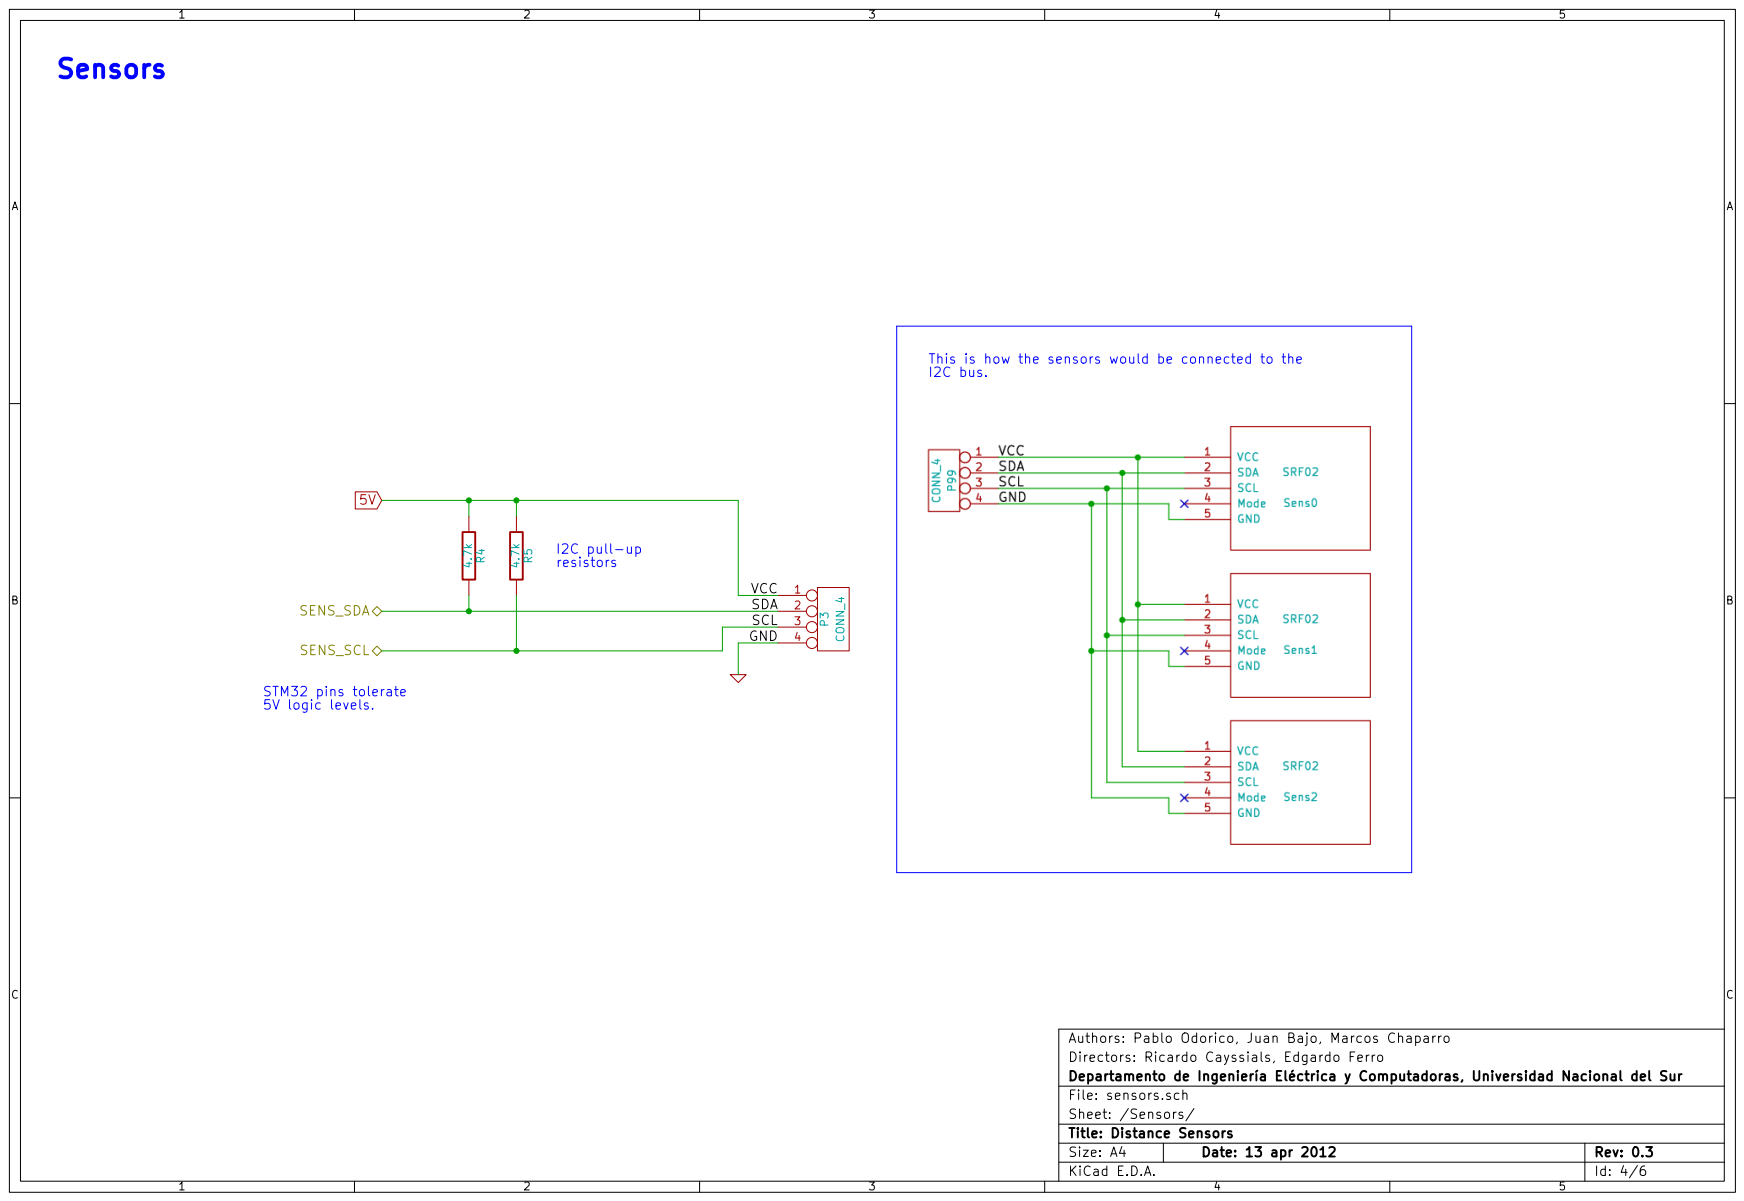
[picture p25: page 5]

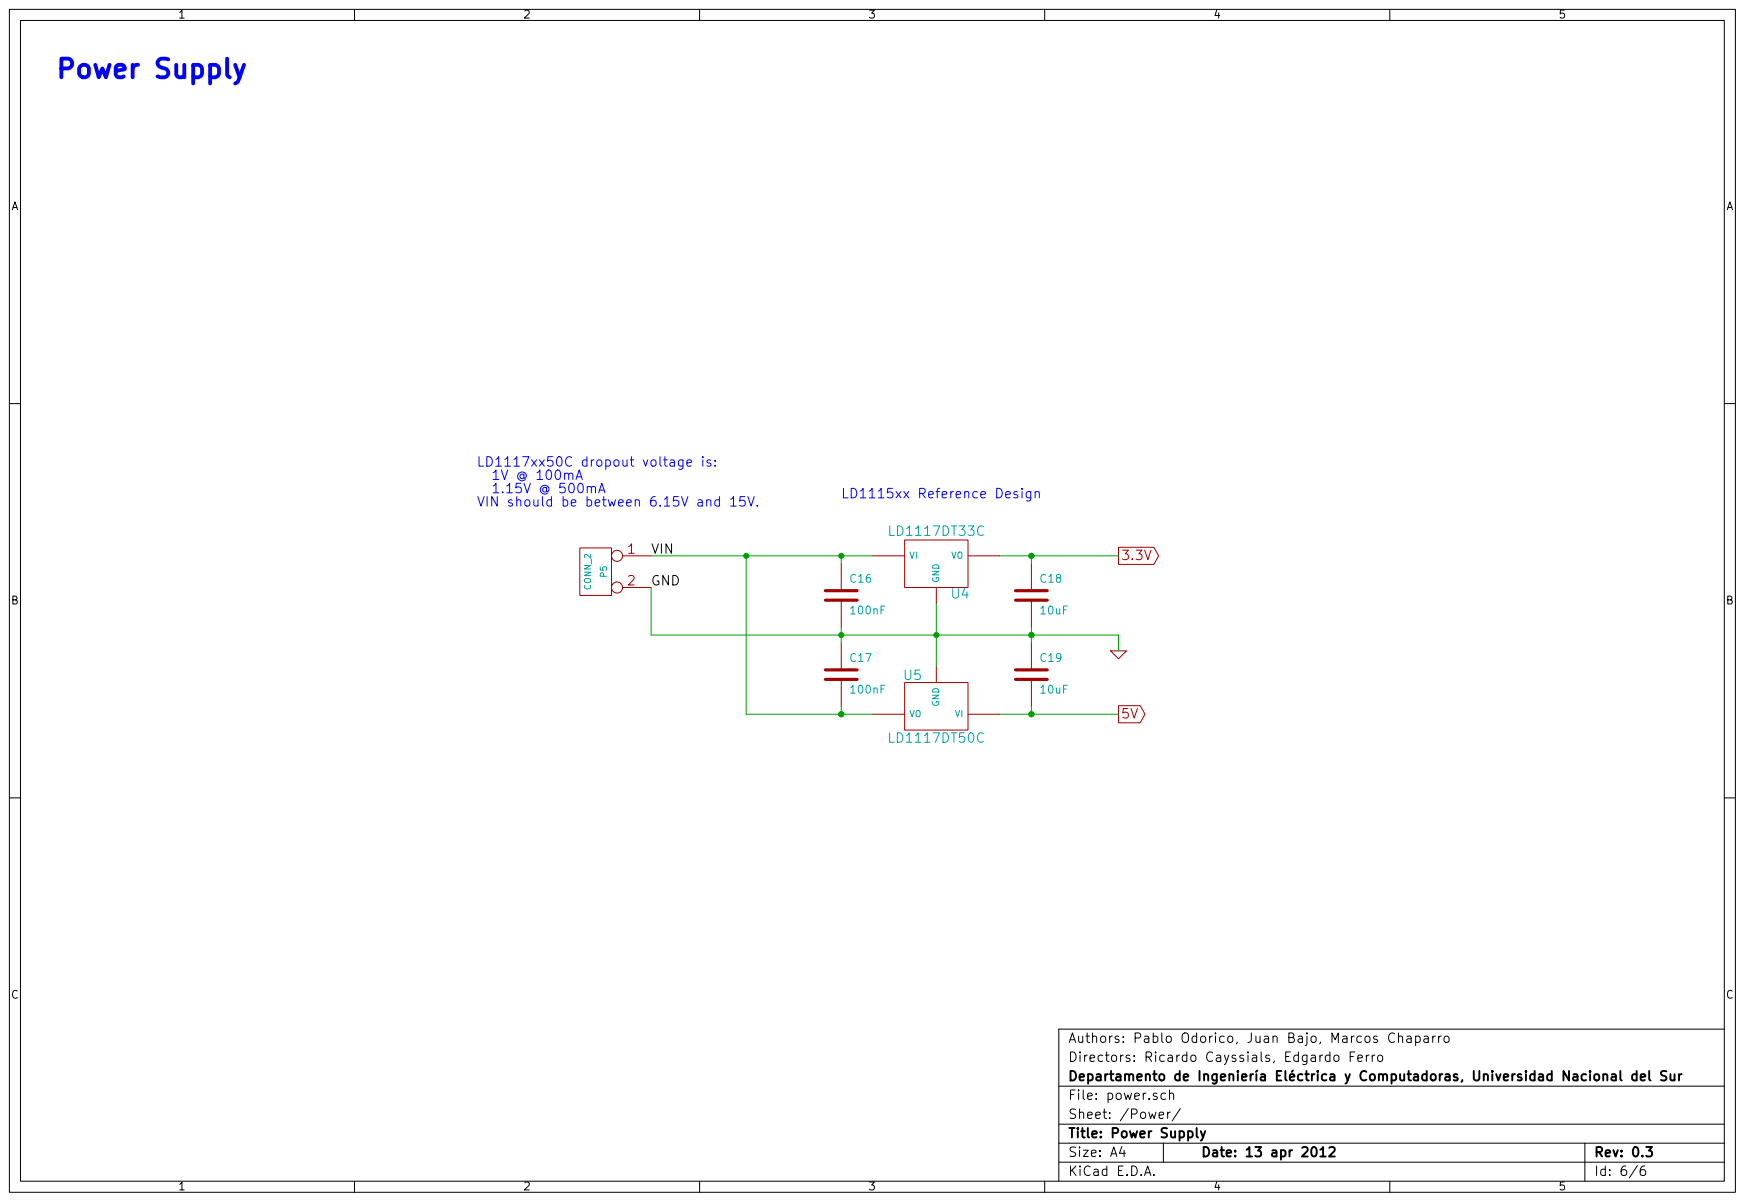
[picture p26: page 6]
