marcos-paltatech/sonar-invidentes/hardware/doc/sonar_board_v02.pdf

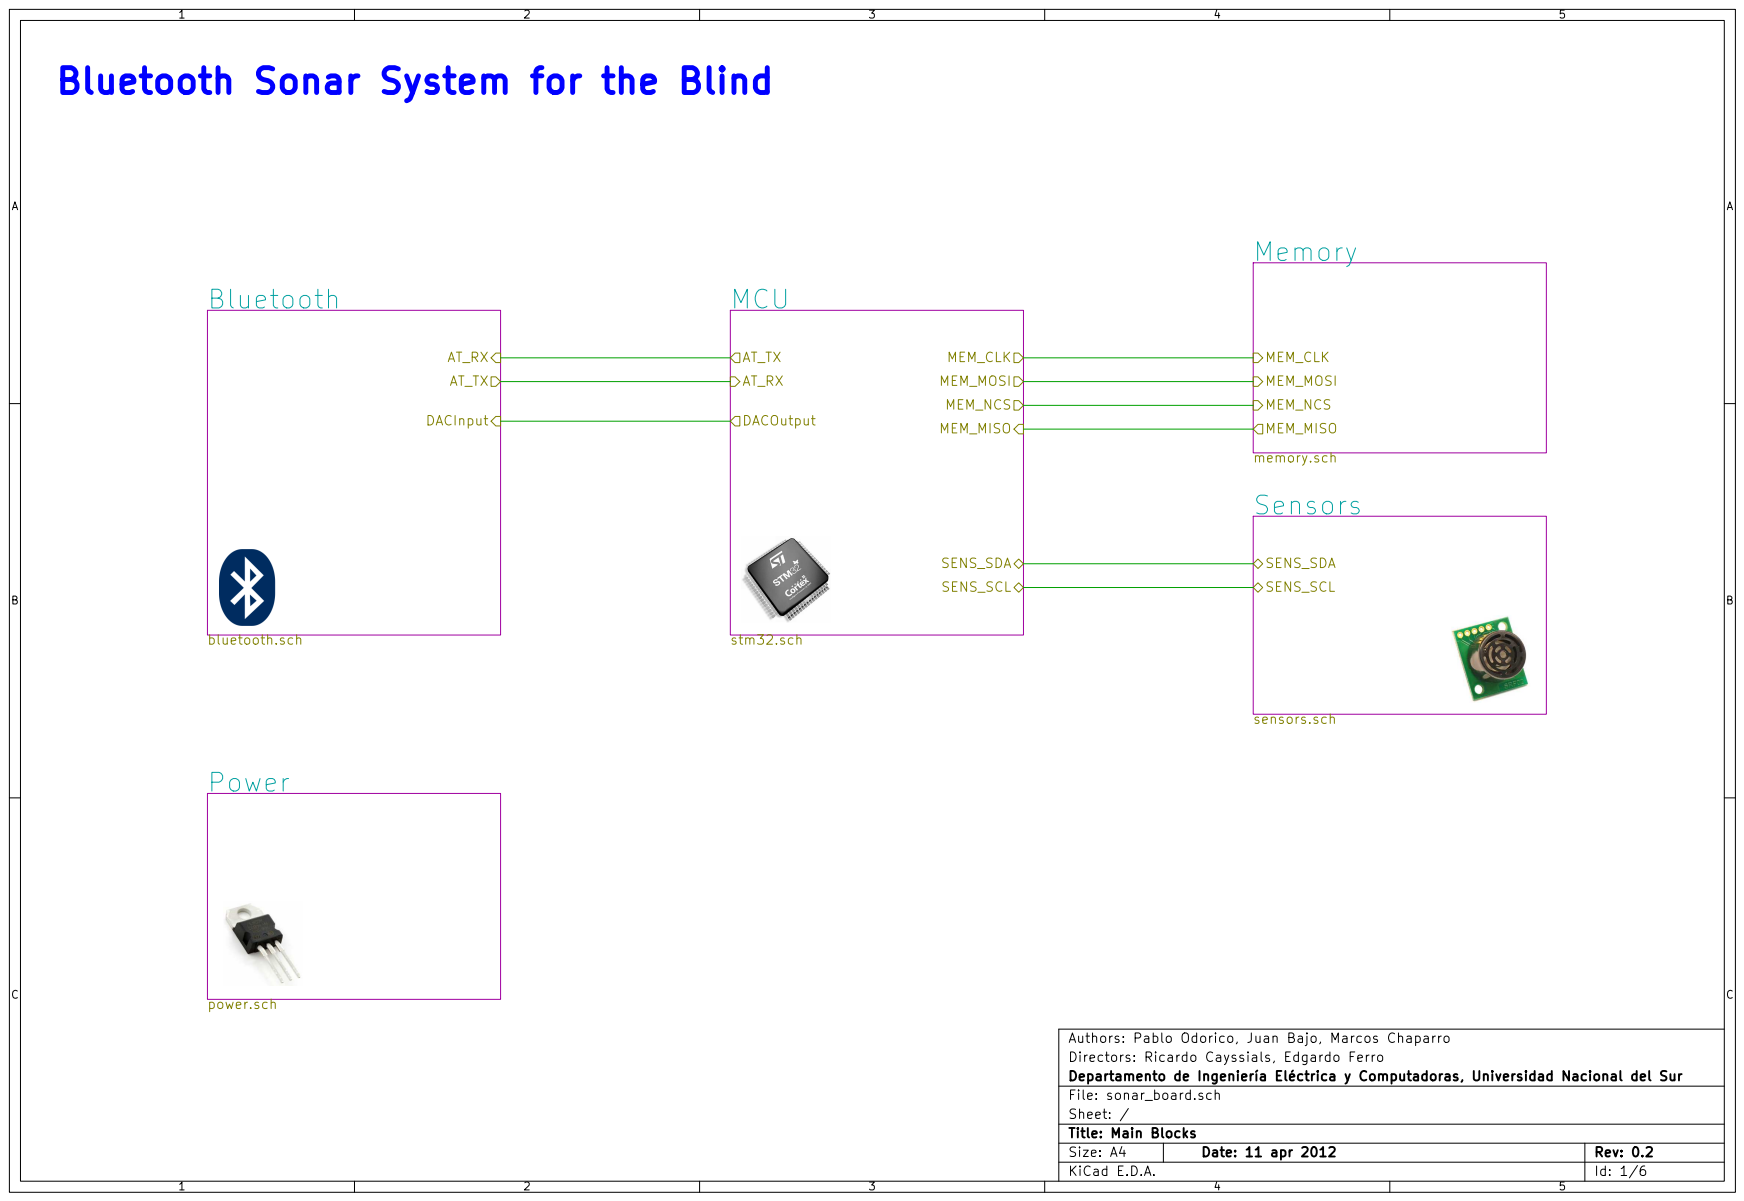
[picture p27: page 1]

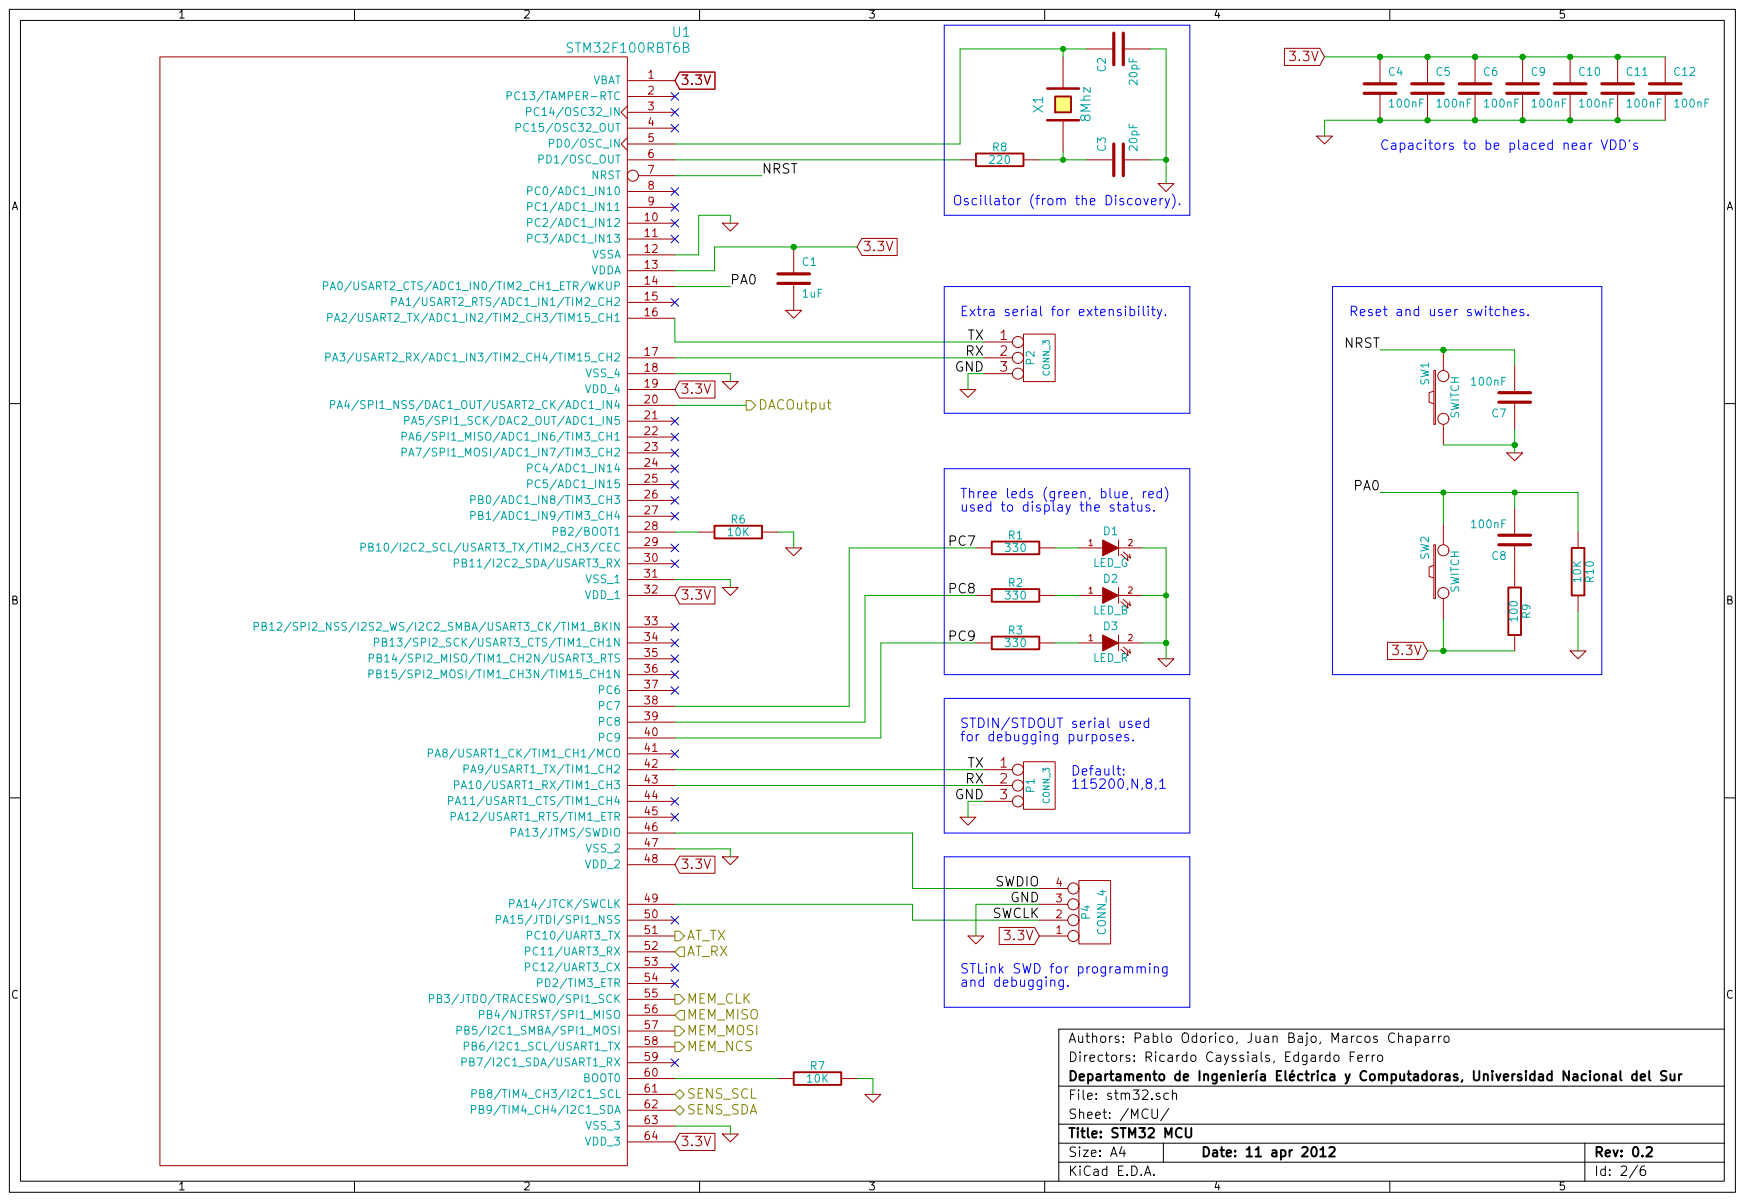
[picture p28: page 2]

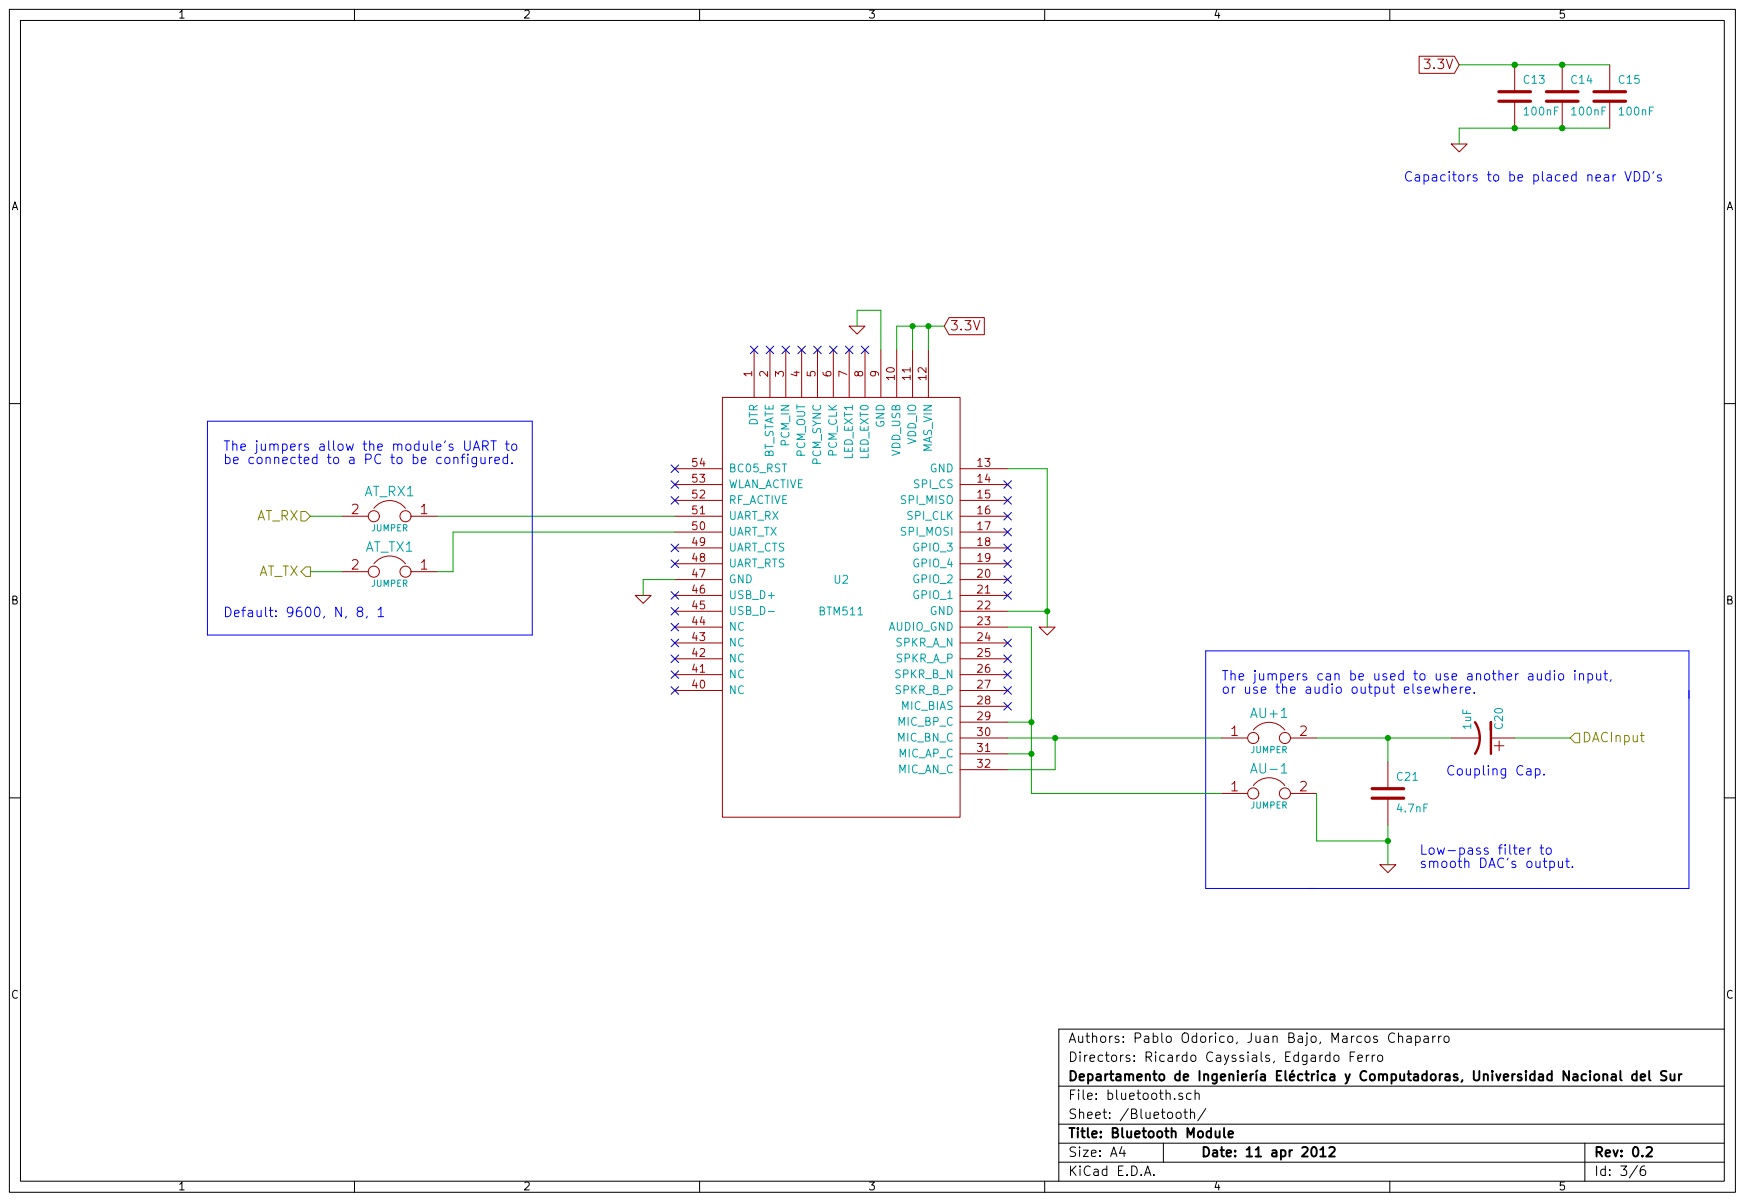
[picture p29: page 3]

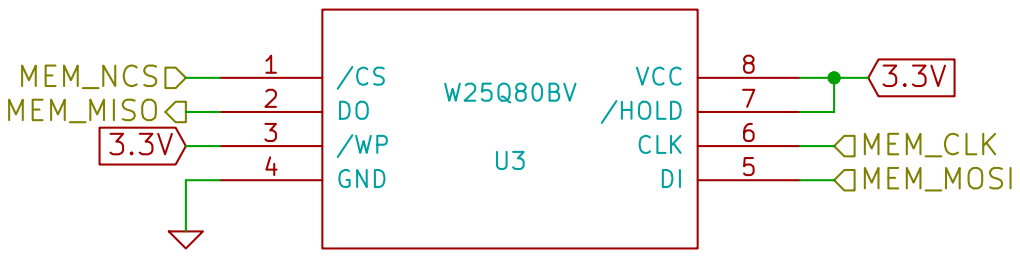
[picture p30: page 4]

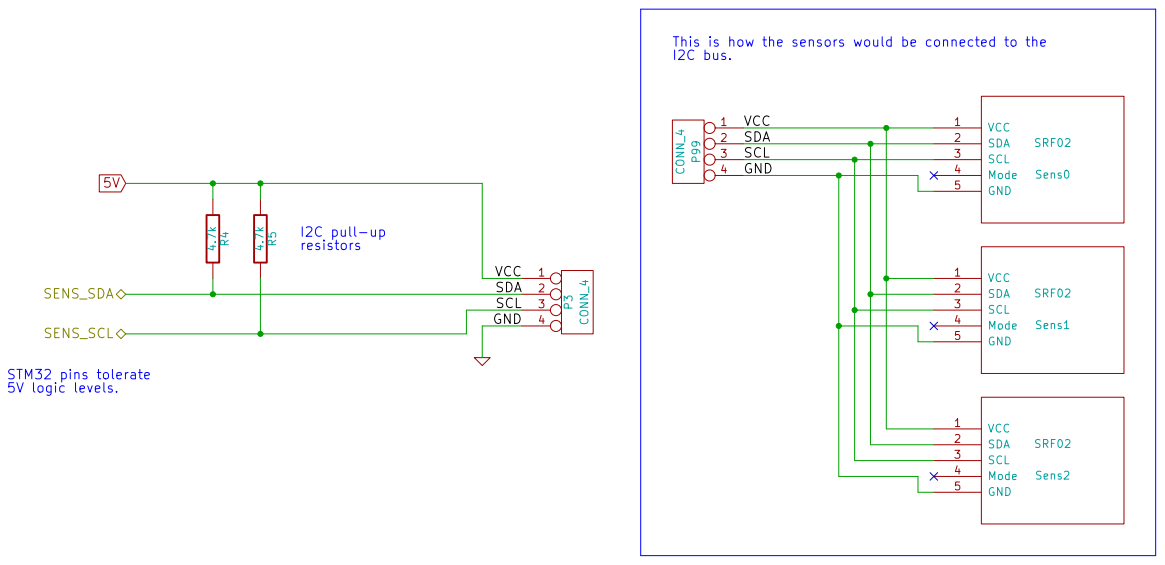
[picture p31: page 5]

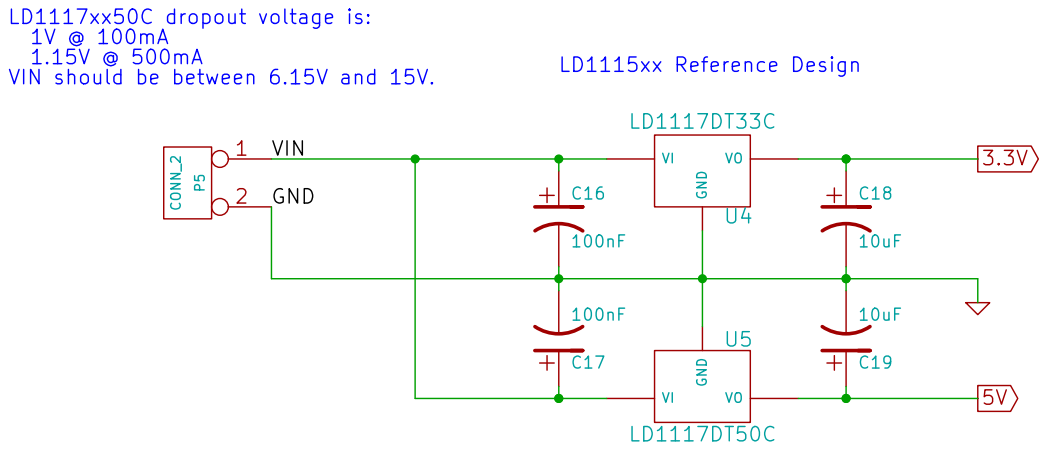
[picture p32: page 6]
