marcos-paltatech/sonar-invidentes/hardware/bluetooth.sch

## KiCad design hardware/bluetooth.sch (2012-04-17)

Schematic: bluetooth.sch

Parts:
BTAT1, BTAT2: JUMPER; mfg# 68001-202HLF
C13, C14, C15: 100nF; mfg# C0603C104K4RACTU
C20: 1uF; mfg# GRM188R60J105KA01D
C21: 4.7nF; mfg# CC0603KRX7R9BB472
SND1, SND2: JUMPER; mfg# 68001-202HLF
U2: BTM511; mfg# BTM511

Notes on the sheet:
Coupling Cap., and low-pass filter to smooth DAC's output.
The jumpers allow the module to use another audio input, or to use the MCU's audio output elsewhere (eg. headphones).
Default: 9600, N, 8, 1
Capacitors to be placed near VDD's
Bluetooth Module
The jumpers allow the module's UART to be connected to a PC for configuration purposes.
