marcos-paltatech/sonar-invidentes/hardware/memory.sch

## KiCad design hardware/memory.sch (2012-04-17)

Schematic: memory.sch

Parts:
C22: 100nF; mfg# C0603C104K4RACTU
U3: SST25VF080B; MODULE; mfg# SST25VF080B-80-4I-SAE

Notes on the sheet:
Flash Memory
