marcos-paltatech/sonar-invidentes/hardware/power.sch

## KiCad design hardware/power.sch (2012-04-17)

Schematic: power.sch

Parts:
BT1: BATTERY; mfg# 534-1294
C16, C17, C25: 100nF; mfg# C0603C104K4RACTU
C18, C19: 10uF; mfg# JMK212BJ106KD-T
R11: 499K; mfg# ERJ-3EKF4993V
R12: 100k; mfg# ERJ-3EKF1003V
U4: LD1117DT33C; mfg# LD1117DT33CTR
U5: LD1117DT50C; mfg# LD1117DT50CTR

Notes on the sheet:
LD1117xx50C dropout voltage is: 1V @ 100mA 1.15V @ 500mA VIN should be between 6.15V and 15V.
LD1115xx Reference Design
Power Supply
1:5 voltage divider to measure battery level. 15V will map to 3V 9V will map to 1.8V
