marcos-paltatech/sonar-invidentes/hardware/sensors.sch

## KiCad design hardware/sensors.sch (2012-04-17)

Schematic: sensors.sch

Parts:
C12, C23, C24: 10uF; mfg# C0603C104K4RACTU
R4, R5: 4.7k; mfg# ERJ-3EKF4701V
S1, S2, S3: SRF02; MODULE; mfg# 77315-113-04LF

Notes on the sheet:
I2C pull-up resistors
STM32 pins tolerate 5V logic levels.
Sensors
Sensors connected to the I2C bus.
Capacitors to be placed near VDD's
