marcos-paltatech/sonar-invidentes/hardware/stm32.sch

## KiCad design hardware/stm32.sch (2012-04-17)

Schematic: stm32.sch

Parts:
C1: 1uF; mfg# GRM188R60J105KA01D
C2, C3: 20pF; mfg# C1608C0G1H200JT
C4, C5, C6, C7, C8, C9, C10, C11: 100nF; mfg# C0603C104K4RACTU
D1: LED_G; mfg# APT2012SGC
D2: LED_Y; mfg# APT2012SYCK
D3: LED_R; mfg# APT2012EC
P1, P2: CONN_3; mfg# 68000-103HLF
P4: CONN_4; mfg# 68001-104HLF
R1, R2, R3: 1k; mfg# ERJ-3EKF3000V
R6, R7, R10: 10K; mfg# ERJ-3EKF1002V
R8, R9: 220; mfg# ERJ-3EKF2200V
SW1: SWITCH; mfg# B3FS-1012
U1: STM32F100RBT6B; mfg# STM32F100RBT6B
X1: 8Mhz; mfg# ECS-80-20-4X

Notes on the sheet:
STDIN/STDOUT serial used for debugging purposes.
Params: 115200,N,8,1
Extra UART/ADC/GPIO for extensibility.
Three leds (green, blue, red) used to display the status.
STLink SWD for programming and debugging.
User switch
Oscillator (from the Discovery).
Capacitors to be placed near VDD's
MCU
