marcos-paltatech/sonar-invidentes/hardware_proto/sonar.sch

## KiCad design hardware_proto/sonar.sch (2012-04-10)

Schematic: sonar.sch

Parts:
1uF: CP1
4.7nF: C
DLP1: DLP-USB232R; MODULE
Flash1: W25Q80BV; MODULE
Rp1, Rp2: 2.14k
STLink1: USB_2
Sensor1, Sensor2, Sensor3: SRF02; MODULE
U1: STM32VLDISCOVERY; MODULE
U2: BTM511; MODULE
USB1: USB_2

Notes on the sheet:
Pasa bajos para redondear la señal del DAC
Coupling Cap
Debugging I/O
Fuente de 5V regulada, para disminuir ruido en el DAC.
