marcos-paltatech/sonar-invidentes/doc/config_btm.txt

Informacion headset:
	MAC 00:1A:0E:E5:08:1D
	DevClass 0x200404
		Major Service Class: Audio
		Major Device Class: Audio
		Minor Device Class: Headset
	FriendlyName "Motorola H270"

======================================================================
Configuracion
======================================================================	
	
Setear friendly name
	AT+BTN="Sonar"

Setear device class:
	Major Devclass "Phone"
	Minor Devclass "Smartphone"
	Major Service Class "Audio"
	ATS515=$20020C
	
Busqueda:	
	Setear tiempo de busqueda maxima en seg
	ATS517=4
	Setear cantidad de resultados maximos
	ATS518=5

IO/Capability: no input or output
	ATS321=3	

Headset Profile, rol de Gateway de audio	
	ATS102=$8
	
Setear gain de entrada a -1db
	ATS590=2
Desactivar amplificador de microfono
    ATS415=0

Desactivar RING despues de conectarse
    ATS345=0

Desactivar echo de consola:
ATE0

Salvar datos
AT&W

Reiniciar
ATZ
	
======================================================================
Comandos en tiepo de ejecucion
	
Hacer un query de headsets mostrando todos los datos del dispositivo
	AT+BTI200404
	Recibo una MAC por linea y termina con OK
	
Configuracion:
	Setear PIN por defecto
	AT+BTK="0000"
	Recibo OK
	
	AT+BTW001A0EE5081D
	Recibo OK, y luego (pueden ser segundos):
	PAIR 0 001A0EE5081D 00
	Con el primer parametro == 0 si no hubo error

Conexion
	AT+HSGD001A0EE5081D
	
	Recibo
	CONNECT 001A0EE5081D,1108,> # El primer parametro deberia ser la MAC del dev, y el segundo 1108 indicando que somos un audio gateway
	HSG"VGS7" # Indica el volumen actual del auricular
	HSG"VGM9" # Indica la ganancia de microfono actual
	(no recibo ok)
	
	Iniciar transmision de audio
	AT+HSGA
	
	Parar transmision de audio
	AT+HSGR
	
	Cuando la tramision empieza (por mi comando o por el boton) llega
	HSG"AU1"	
	Cuando termina
	HSG"AU0"	
	
Cuando el heaset se apaga manda
	NO CARRIER 1112
	
