marcos-paltatech/sonar-invidentes/SonarBoardProject/distances.h

#ifndef DISTANCES_H
#define DISTANCES_H

#include "sonarboard.h"

// Frecuencia de medicion: 250ms
#define DIST_FREQ	  0.3

void distSetup();

void distStartMeasuring(bool oneShot);
void distStopMeasuring();

void TIM2_IRQHandler();

#endif
