marcos-paltatech/sonar-invidentes/SonarBoardProject/io_retarget.h

#ifndef IO_RETARGET_H
#define IO_RETARGET_H

#include "sonarboard.h"

// Retarget de STDIN/STDOUT por USART1 remapeado a PA9/PA10
void retargetSetup();


// Atollic-specific Redefinitions
int _write_r(void *reent, uint16_t fd, const char *ptr, uint32_t len);
int _read_r(void *reent, uint16_t fd, char *ptr, uint32_t len);

// Leer string terminada con \r de largo maximo len
// Devuelve la cantidad de caracteres leidos: a lo sumo len-1
// En string no tiene los caracteres de fin de linea
int readLine(char *ptr, uint16_t len);

#endif
