marcos-paltatech/sonar-invidentes/(commit log)

2012-03-09 Agregue los datasheets que estaban en Dropbox
2012-03-11 Version actual del codigo para STM32-discovery.
2012-03-11 Agregué archivo que faltaba para el proyecto Atollic
2012-03-11 primera version del esquematico
    [sonar.sch]
2012-03-30 footprint btm511
2012-03-30 varios cambios esquematico
    [bluetooth.sch, sonar.sch]
2012-03-31 Agregue modulo bluetooth a esquematico
    [sonar.sch]
2012-03-31 Documento de instrucciones para configurar modulo bluetooth
    [config_btm.txt]
2012-03-31 version actualizada de sonar.pdf
2012-04-03 Soporte del modulo bluetooth. Cambie el CLI por una linea de comandos.
    [config_btm.txt, sonar.sch]
2012-04-03 Cambios menores de API y agregue algunos comandos.
2012-04-03 Usar el LED azul para ir mostrando el estado de bluetooth.
    [config_btm.txt]
2012-04-03 audiotrack.h que faltaba y un handler basico del boton para reproducir tracks
2012-04-04 cambios menores al esquematico
    [sonar.sch]
2012-04-06 cambios varios
    [config_btm.txt, sonar.sch]
2012-04-06 fuente externa en el esquematico
    [sonar.sch]
2012-04-09 tracks y cambios varios
    [config_btm.txt]
2012-04-09 modifique flashmem para que mande el comando al shell del MCU
2012-04-09 flashmem generaba mal el codigo C
2012-04-09 cambios varios, audioplayer usa el led verde
2012-04-10 Polaridad de coupling cap y cap pasa bajos
    [sonar.sch]
2012-04-10 sonar.pdf actualizado
2012-04-11 nuevo esquematico para la placa
    [bluetooth.sch, memory.sch, power.sch, sensors.sch, sonar.sch, sonar_board.sch, stm32.sch]
2012-04-11 cambios varios al esquematico
    [bluetooth.sch, memory.sch, power.sch, sensors.sch, sonar_board.sch, stm32.sch]
2012-04-11 .pro, anotaciones y correcciones electricas, .gitignore
    [bluetooth.sch, memory.sch, power.sch, sensors.sch, sonar_board.sch, stm32.sch]
2012-04-11 cambios menores
    [bluetooth.sch, memory.sch, power.sch, sensors.sch, sonar_board.sch, stm32.sch]
2012-04-11 cambios menores, netlist y cmp a medio hacer
    [bluetooth.sch, memory.sch, power.sch, sensors.sch, sonar_board.sch, stm32.sch]
2012-04-11 varias correcciones, listo para rfc
    [bluetooth.sch, memory.sch, power.sch, sensors.sch, sonar_board.sch, stm32.sch]
2012-04-11 Cambios varios para manejar mejor las interrupciones.
2012-04-12 cambios varios, mfg# para todos los componentes
    [bluetooth.sch, memory.sch, power.sch, sensors.sch, sonar_board.sch, stm32.sch]
2012-04-12 v0.3, incluye: correcciones, mfg#'s, footprints asociados
    [bluetooth.sch, memory.sch, power.sch, sensors.sch, sonar_board.csv, sonar_board.sch, stm32.sch]
2012-04-14 primera version pcb
    [bluetooth.sch, memory.sch, power.sch, sensors.sch, sonar_board.brd, sonar_board.sch, stm32.sch]
2012-04-14 placa actualizada
    [bluetooth.sch, memory.sch, power.sch, sensors.sch, sonar_board.brd, sonar_board.sch, stm32.sch]
2012-04-14 mejor ruteo uart at
    [sonar_board.brd]
2012-04-14 pcb actualizado, cambios varios y logo de la uns
2012-04-15 lo que seria la version 0.4
    [bluetooth.sch, bom.csv, memory.sch, power.sch, sensors.sch, sonar_board.brd, sonar_board.sch, stm32.sch]
2012-04-15 acomode las referencias de componentes en la placa
    [sonar_board.brd]
2012-04-16 comando de reset
2012-04-17 Version 0.4, lista para fabricar
    [bluetooth.sch, memory.sch, power.sch, sensors.sch, sonar_board.brd, sonar_board.sch, stm32.sch]
2012-04-20 Proyecto para la placa en CooCox con varios cambios.
2012-05-12 Cambios para soportar la SonarBoard
2012-05-19 Lectura de valor de bateria y cambios varios
2012-05-22 ultimos cambios, sensores+memoria andando
